crispycookies/watchPLB/eagle/BOMs/BOMs_WatchPLB.xlsx

Sheet: Mainboard
Qty | Value | Device | Package | Parts | Description | Vorhanden | Link
22 | PTR1B1,27 | PTR1B1,27 | B1,27 | 3V3, BAT_ADC, BAT_PACK_POS, BTN_1, BTN_2, BTN_3, BTN_4, BTN_NRST, BT_RX, BT_TX, NRST_MCU, RF_SYSCLK, SPI2_CLK, SPI2_IRQ, SPI2_MISO, SPI2_MOSI, SPI2_SEL_RFTX, SWD_RXD, SWD_TXD, USB_DN, USB_DP, USB_ID | TEST PIN |  | x
6 | BLM18KG601SN1D | B-EU_B0603 | L0603 | B1, B3, B4, B5, B6, B7 | EMI Filter | n | https://www.mouser.at/ProductDetail/Murata-Electronics/BLM18KG601SN1D
2 |  | PINHD-1X5 | 1X05 | BAT, CONFIG_INTERFACE_TEST_POINT | PIN HEADER |  | x
3 | 1uF | C-EUC0805 | C0805 | C10, C20, C27 | CAPACITOR, European symbol | n | https://www.mouser.at/ProductDetail/Yageo/CC0805KKX5R6BB105
2 | 27p | C-EUC0805 | C0805 | C14, C15 | CAPACITOR, European symbol | n | https://www.mouser.at/ProductDetail/KEMET/C0805C270J1GACTU?qs=sGAEpiMZZMs0AnBnWHyRQOf5HOpVaXbhYFtZQxfz6Es%3d
1 | CSTCE12M0G15L99-R0 | CSTCE8M00G52-R0 | CSTCE | C19 |  | y | https://www.mouser.at/ProductDetail/Murata-Electronics/CSTCE12M0G15L99-R0
2 | 27pF | C-EUC0805 | C0805 | C25, C26 | CAPACITOR, European symbol | y | https://www.mouser.at/ProductDetail/KEMET/C0805C270J1GACTU?qs=sGAEpiMZZMs0AnBnWHyRQOf5HOpVaXbhYFtZQxfz6Es%3d
2 | 7.5pF | C-EUC0805 | C0805 | C28, C31 | CAPACITOR, European symbol | y | https://www.mouser.at/ProductDetail/KEMET/C0805C759C5HACTU
2 | 2.7pF | C-EUC0805 | C0805 | C29, C30 | CAPACITOR, European symbol | n | https://www.mouser.at/ProductDetail/Vishay-Vitramon/VJ0805A2R7BXAPW1BC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
2 | 6pF | C-EUC0805 | C0805 | C32, C33 | CAPACITOR, European symbol | y | https://www.mouser.at/ProductDetail/AVX/08055A6R0CAT2A?qs=sGAEpiMZZMs0AnBnWHyRQEncggutzp42xImDo6lXcbY%3d
2 | 5.2pF | C-EUC0805 | C0805 | C34, C35 | CAPACITOR, European symbol | n | https://www.mouser.at/ProductDetail/KEMET/CBR08C529C5GAC
2 | NC | C-EUC0805 | C0805 | C36, C37 | CAPACITOR, European symbol |  | x
9 | 100nF | C-EUC0805K | C0805K | C38, C39, C40, C41, C44, C45, C46, C47, C49 | CAPACITOR, European symbol | n | https://www.mouser.at/ProductDetail/Wurth-Electronics/885012207098
15 | 100nF | C-EUC0805 | C0805 | C4, C5, C6, C7, C8, C11, C12, C13, C16, C17, C18, C21, C22, C23, C24 | CAPACITOR, European symbol | n | https://www.mouser.at/ProductDetail/Wurth-Electronics/885012207098
2 | 1uF | C-EUC0805K | C0805K | C42, C43 | CAPACITOR, European symbol | n | https://www.mouser.at/ProductDetail/Yageo/CC0805KKX5R6BB105
3 | 22uF | CPOL-EUE | PANASONIC_E | C48, C51, C52 | POLARIZED CAPACITOR, European symbol, 80-EDK226M050A9GAA | y | https://www.mouser.at/ProductDetail/KEMET/EDK226M050A9GAA
3 | 10uF | CPOL-EUE | PANASONIC_E | C53, C56, C59 | POLARIZED CAPACITOR, European symbol, 80-EDK106M025A9DAA | y | https://www.mouser.at/ProductDetail/KEMET/EDK106M025A9DAA
3 | 100uF | CPOL-EUE | PANASONIC_E | C54, C57, C60 | POLARIZED CAPACITOR, European symbol, 647-GYA1E101MCQ1GS | y | https://www.mouser.at/ProductDetail/Nichicon/GYA1E101MCQ1GS
3 | NP | CPOL-EUE | PANASONIC_E | C55, C58, C61 | POLARIZED CAPACITOR, European symbol |  | x
1 | 4.7uF | CPOL-EUB/3528-21R | B/3528-21R | C63 | POLARIZED CAPACITOR, European symbol, low esr 80-T521B475M35ATE150 | y | https://www.mouser.at/ProductDetail/KEMET/T521B475M035ATE150
1 | 10uF | C-EUC1206 | C1206 | C9 | CAPACITOR, European symbol | y | https://www.mouser.at/ProductDetail/Vishay-Vitramon/VJ1206G106KXYTW1BC
1 | S8NC-13 | DIODE-SMC | SMC | D1 | DIODE | y | https://www.mouser.at/ProductDetail/Diodes-Incorporated/S8NC-13
1 | MBRS330T3 | MBRS330T3 | SMC | D10 | SCHOTTKY BARRIER RECTIFIER 3.0 AMPERES 20, 30, 40 VOLT | y | https://www.mouser.at/ProductDetail/ON-Semiconductor/MBRS330T3G
6 | 1N4148 | DIODESOD-123 | SOD-123 | D2, D3, D4, D5, D8, D9 | Diode | y | https://www.mouser.at/ProductDetail/Diodes-Incorporated/1N4148W-7-F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
1 | Zener 16V | DIODE-SOD323-R | SOD323-R | D6 | DIODE, MMSZ5246BS-7-F | y | https://www.mouser.at/ProductDetail/Diodes-Incorporated/MMSZ5246BS-7-F
1 | 100V, BAS16J,135 | DIODE-SOD323-R | SOD323-R | D7 | DIODE | y | https://www.mouser.at/ProductDetail/Nexperia/BAS16J135?qs=sGAEpiMZZMtoHjESLttvkoI3HUJtjVU1BZwVLB9Jeuw%3d
3 | BLM18PG300SN1D | FERRITE_BEAD-0603 | 0603 | FB1, FB3, FB4 | Ferrite Bead (blocks, cores, rings, chokes, etc.) | y | https://www.mouser.at/ProductDetail/Murata-Electronics/BLM18PG300SN1D
1 |  | PINHD-1X8 | 1X08 | GPS> | PIN HEADER |  | x
1 | LT1513 | LT1513 | TO220-7 | IC1 | Battery Charger Buck/Boost | y | https://www.mouser.at/ProductDetail/Analog-Devices-Linear-Technology/LT1513-2CRPBF
1 | BM70BLES1FC2-0B03AA | BM70BLES1FC2-0B03AA | BM78SPPS5NC2_1 | IC2 | Bluetooth / 802.15.1 Modules | y | https://www.mouser.at/ProductDetail/Microchip-Technology/BM70BLES1FC2-0B03AA
1 | LM1117DTX-ADJ-12V | LM1117DTX-ADJ | TO252 | IC3 |  | n | https://www.mouser.at/ProductDetail/Texas-Instruments/LM1117DTX-ADJ-NOPB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
1 | AX5031 | AX5031 | QFN20 | IC4 | AX5031 RF Transmitter 400-470MHz 800-940MHz | y | https://www.mouser.at/ProductDetail/ON-Semiconductor/AX5031-1-TW30
1 | LM1117DTX-ADJ-10V | LM1117DTX-ADJ | TO252 | IC5 |  | y | https://www.mouser.at/ProductDetail/Texas-Instruments/LM1117DTX-ADJ-NOPB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
1 | LM1117DTX-ADJ-3V3 | LM1117DTX-ADJ | TO252 | IC6 |  | y | https://www.mouser.at/ProductDetail/Texas-Instruments/LM1117DTX-ADJ-NOPB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
3 |  | USB_MICRO-B_FEMALE-SMT | USB-B-MICRO-SMD | J1, J2, J4 | USB Type Micro-B Connector | y | https://www.mouser.at/ProductDetail/Amphenol-FCI/10118192-0001LF
1 | BNCPTH | BNCPTH | BNC | J3 | BNC Right Angle Connector | y | https://www.sparkfun.com/products/10550
1 | VIB_MOTOR | PINHD-1X2 | 1X02 | JP2 | PIN HEADER, 619-28821 | n | https://www.mouser.at/ProductDetail/Parallax/28821
1 | Power Disconnect | PINHD-1X2 | 1X02 | JP3 | PIN HEADER |  | x
2 | 39nH | INDUCTOR-0805-3.3UH | 0805 | L1, L4 | Inductors | y | https://www.mouser.at/ProductDetail/Bourns/CE201210-39NJ
2 | 120nH | INDUCTOR-0805-3.3UH | 0805 | L2, L3 | Inductors | y | https://www.mouser.at/ProductDetail/Bourns/CV201210-R12K
2 | 27nH | INDUCTOR-0805-3.3UH | 0805 | L5, L6 | Inductors | y | https://www.mouser.at/ProductDetail/Bourns/CE201210-27NJ
1 | 0R | INDUCTOR-0805-3.3UH | 0805 | L7 | Inductors | y | https://www.mouser.at/ProductDetail/Vishay-Draloric/RCG08050000Z0EA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
1 | CTX10-4A-R | CTX10-4A-R | INDM115115X635N | L8 | POWER INDUCTOR | y | https://www.mouser.at/ProductDetail/Coiltronics-Eaton/CTX10-4A-R
2 | BLUE | LEDCHIP-LED0805 | CHIP-LED0805 | LED1, LED3 | LED | n | https://www.mouser.at/ProductDetail/Wurth-Electronics/150080BS75000
1 | YELLOW | LEDCHIP-LED0805 | CHIP-LED0805 | LED10 | LED | n | https://www.mouser.at/ProductDetail/Wurth-Electronics/150080YS75000
5 | GREEN | LEDCHIP-LED0805 | CHIP-LED0805 | LED2, LED6, LED7, LED8, LED11 | LED | n | https://www.mouser.at/ProductDetail/Wurth-Electronics/150080GS75000
1 | WHITE | LEDCHIP-LED0805 | CHIP-LED0805 | LED4 | LED | y | https://www.mouser.at/ProductDetail/Lite-On/LTW-170TK
3 | RED | LEDCHIP-LED0805 | CHIP-LED0805 | LED5, LED9, LED12 | LED | n | https://www.mouser.at/ProductDetail/Wurth-Electronics/150080RS75000
1 | SWD | PINHD-1X5 | 1X05 | PR0> | PIN HEADER |  | x
1 | 8MHz-Crystal | CRYSTALHC49UP | HC49UP | Q1 | CRYSTAL, 8MHz / LFXTAL020423Reel | y | https://www.mouser.at/ProductDetail/IQD/LFXTAL020423Bulk
1 | BC817-25SMD | BC817-25SMD | SOT23-BEC | Q2 | NPN Transistor | y | https://www.mouser.at/ProductDetail/ON-Semiconductor/BC817-16LT3G
2 | DMN3023L-7 | BSS123 | SOT23 | Q3, Q7 | N-CHANNEL MOS FET | y | https://www.mouser.at/ProductDetail/Diodes-Incorporated/DMN3023L-7
1 | 16MHz_Crystal | CRYSTALHC49UP | HC49UP | Q4 | CRYSTAL, 16MHz_LFXTAL051370Reel | y | https://www.mouser.at/ProductDetail/IQD/LFXTAL051370Reel
2 | CSD18534Q5A | CSD18534Q5A | TRANS_CSD18534Q5A | Q5, Q6 | 60V N-Channel NexFET Power? MOSFET 8-VSON-FET -55 to 150 | y | https://www.mouser.at/ProductDetail/Texas-Instruments/CSD18534Q5AT
9 | 470R | R-EU_M0805 | M0805 | R10, R11, R14, R15, R18, R19, R20, R21, R22 | RESISTOR, European symbol | n | https://www.mouser.at/ProductDetail/Bourns/CR0805-FX-4700ELF?qs=sGAEpiMZZMtlubZbdhIBIDEmHCAUH0R0Vf1IHPeLRm0%3d
2 | 100k | R-EU_M0805 | M0805 | R25, R26 | RESISTOR, European symbol | n | https://www.mouser.at/ProductDetail/Susumu/RR1220P-104-D?qs=sGAEpiMZZMtlubZbdhIBIHPiT0YkkodQxrHTIurjrno%3d
1 | 1k5 | R-EU_M0805 | M0805 | R27 | RESISTOR, European symbol | n | https://www.mouser.at/ProductDetail/Susumu/RR1220P-152-D?qs=sGAEpiMZZMtlubZbdhIBIHPiT0YkkodQ7VAZokmK9Jk%3d
1 | 36k | R-EU_M0805 | M0805 | R28 | RESISTOR, European symbol | y | https://www.mouser.at/ProductDetail/Vishay/CRCW080536K0FKEA
1 | 4k7 | R-EU_M0805 | M0805 | R3 | RESISTOR, European symbol | n | https://www.mouser.at/ProductDetail/Susumu/RR1220P-472-D
5 | 1k | R-EU_M0805 | M0805 | R30, R31, R32, R33, R34 | RESISTOR, European symbol | n | https://www.mouser.at/ProductDetail/Susumu/RR1220P-102-D
1 | 20mR | R-EU_R2512 | R2512 | R36 | RESISTOR, European symbol | y | https://www.mouser.at/ProductDetail/Vishay-Dale/RCWE251220L0FMEA
2 | 100R | R-EU_M0805 | M0805 | R37, R38 | RESISTOR, European symbol | n | https://www.mouser.at/ProductDetail/Susumu/RR1220P-101-D?qs=sGAEpiMZZMtlubZbdhIBIHPiT0YkkodQf9vl5gvjsrU%3d
1 | 10M | R-EU_M0805 | M0805 | R39 | RESISTOR, European symbol | n | https://www.mouser.at/ProductDetail/Vishay/CRCW080510M0FKEB?qs=sGAEpiMZZMtlubZbdhIBIKpw3Cj3Rl3MNI5nZ86TRkY%3d
5 | 47k | R-EU_M0805 | M0805 | R4, R54, R56, R58, R60 | RESISTOR, European symbol | n | https://www.mouser.at/ProductDetail/Bourns/CR0805-FX-4702ELF?qs=sGAEpiMZZMtlubZbdhIBIDEmHCAUH0R0BYFVnl4ZjVo%3d
5 | 5k1 | R-EU_M0805 | M0805 | R40, R43, R53, R55, R57 | RESISTOR, European symbol | y | https://www.mouser.at/ProductDetail/Bourns/CR0805-FX-5101ELF
1 | 3M3 | R-EU_M0805 | M0805 | R41 | RESISTOR, European symbol | y | https://www.mouser.at/ProductDetail/Vishay/CRCW08053M30FKEA
1 | 1M | R-EU_M0805 | M0805 | R42 | RESISTOR, European symbol | n | https://www.mouser.at/ProductDetail/Vishay-Draloric/RCG08051M00FKEA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
1 | 470k | R-EU_M0805 | M0805 | R44 | RESISTOR, European symbol | n | https://www.mouser.at/ProductDetail/Susumu/RR1220P-474-D
1 | 330 | R-EU_M0805 | M0805 | R45 | RESISTOR, European symbol | n | https://www.mouser.at/ProductDetail/Susumu/RR1220P-331-D
1 | 910R | R-EU_M0805 | M0805 | R46 | RESISTOR, European symbol | y | https://www.mouser.at/ProductDetail/Susumu/RR1220P-911-D
1 | 330k | R-EU_M0805 | M0805 | R48 | RESISTOR, European symbol | n | https://www.mouser.at/ProductDetail/Susumu/RR1220P-334-D
14 | 10k | R-EU_M0805 | M0805 | R5, R6, R7, R8, R12, R13, R16, R17, R35, R47, R49, R59, R61, R29 | RESISTOR, European symbol | y | https://www.mouser.at/ProductDetail/Susumu/RR1220P-103-D?qs=sGAEpiMZZMtlubZbdhIBIHPiT0YkkodQv1fGEJmXcHQ%3d
1 | 0.25R | R-EU_R2512 | R2512 | R50 | RESISTOR, European symbol | y | https://www.mouser.at/ProductDetail/Yageo/RL2512FK-070R25L
1 | 120k | R-EU_M0805 | M0805 | R51 | RESISTOR, European symbol | n | https://www.mouser.at/ProductDetail/Vishay/CRCW0805120KFKEB?qs=sGAEpiMZZMtlubZbdhIBIMnmA7lvh4oLM85S5wRYrbI%3d
1 | 12k4 | R-EU_M0805 | M0805 | R52 | RESISTOR, European symbol | y | https://www.mouser.at/ProductDetail/Susumu/RR1220P-1242-D-M?qs=sGAEpiMZZMtlubZbdhIBIHPiT0YkkodQJw4mRx63pQY%3d
1 | NTC 103AT | R-EU_M0805 | M0805 | R62 | RESISTOR, European symbol | y | https://www.mouser.at/ProductDetail/Semitec/103AT-4-70374
3 | 220R | R-EU_M0805 | M0805 | R9, R23, R24 | RESISTOR, European symbol | n | https://www.mouser.at/ProductDetail/Susumu/RR1220P-221-D
1 | PTR1B2,54 | PTR1B2,54 | B2,54 | RF_SIGNAL | TEST PIN |  | x
5 |  | TL3305 | SMD_SWITCH | S1, S2, S3, S4, S5 | OMRON SWITCH | y | https://www.mouser.at/ProductDetail/E-Switch/TL3305AF260QG
1 | RA07H4047M | RA07H4047M | RA07H4047M | U$2 |  | y | https://www.rfparts.com/module/rfpower-mosfet/mosfetpowermod-uhflp/ra07h4047m.html
1 | MCP111-XXXXX/TO | MCP111-XXXXX/TO | TO-92_MC | U1 |  | y | https://www.mouser.at/ProductDetail/Microchip-Technology/MCP111T-195I-LB?qs=sGAEpiMZZMsUzhEcHltCuaykJbWoyfaD
1 | STM32L073RZ | STM32L0X3RL | LQFP64-10X10MM | U2 |  | y | https://www.mouser.at/ProductDetail/STMicroelectronics/STM32L073RZT6
1 | MCP2200-I/SS | MCP2200-I/SS | SSOP20_MC | U3 |  | y | https://www.mouser.at/ProductDetail/Microchip-Technology/MCP2200-I-SS
1 | TPD3E001DRLR | TPD3E001DRLR | SOT50P160X60-5N | U4 | LOW-CAPACITANCE 3-CHANNEL ±15-kV ESD-PROTECTION ARRAY FOR HIGH-SPEED DATA INTERFACES | y | https://www.mouser.at/ProductDetail/Texas-Instruments/TPD3E001DRLR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
1 | BQ7790504 | BQ77904 | TSSOP-20/6MM | U5 | A battery protection chip with OV/UV/OT/UT | y | https://www.digikey.at/products/de?keywords=296-44599-5-ND
1 | BNC Kabel |  |  |  |  | n | https://www.mouser.at/ProductDetail/AIM-Cambridge-Cinch-Connectivity-Solutions/606BBP
4 | Akku 18650 |  |  |  |  | n | https://eu.nkon.nl/rechargeable/18650-size/lg-inr18650-f1l-3350mah-4-8a.html
1 | Akkuhalter |  |  |  |  | y | https://www.digikey.at/products/de/battery-products/battery-holders-clips-contacts/86?k=18650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
1 | Antenne | av200 |  |  |  | y | http://www.air-store.eu/epages/AIRStore-LuftfahrtbedarfundAvionik.sf/en_GB/
3 | USB Kabel micro |  |  |  |  | 3 von 9 | https://www.mouser.at/ProductDetail/Bridgetek/VA-FC-1M-BKW
1 | Pinheader Male 2.54mm |  |  |  |  | n | https://www.aliexpress.com/item/10Pcs-Lot-40-Pin-2-54mm-1x40-pin-Heigth-11-34MM-Single-Row-Male-straight-male/32873942371.html
1 | Pinheader Female 2.54mm |  |  |  |  | n | https://www.aliexpress.com/item/10Pcs-Lot-40Pin-2-54mm-1x40-pin-socket-Single-Row-Female-straight-female-Pin-Header-Connector/32892752726.html

Sheet: GPS_Board
Qty | Value | Device | Package | Parts | Description | Bezugsquelle
1 |  | PINHD-1X8 | 1X08 | <GPS | PIN HEADER
3 | 1uF | C-EUC0805 | C0805 | C1, C2, C3 | CAPACITOR, European symbol | https://www.mouser.at/ProductDetail/77-VJ0805V105ZXJCBC
1 | 4.7uF | C-EUC0805 | C0805 | C4 | CAPACITOR, European symbol | https://www.mouser.at/ProductDetail/710-885012107013
2 | 47k | R-EU_M0805 | M0805 | R1, R2 | RESISTOR, European symbol | https://www.mouser.at/ProductDetail/667-ERJ-2GEJ473X
1 | BLM18KG601SN1D | B-EU_B0603 | L0603 | B2 | EMI Filter | https://www.mouser.at/ProductDetail/81-BLM18KG601SN1D
1 | SAM-M8Q | SAM-M8Q | SAM-M8Q | IC1 | u-blox SAM GNSS antenna module | https://www.u-blox.com/de/product/sam-m8q-module
