crispycookies/watchPLB/Berechnungen.xlsx

Sheet: BatteryCharger
vBat | 16.8 | V | Vbat error | 0.001379903852
R2 | 12400 | Ohm | R52
R1 | 154463.7709 | Ohm | R51 | 150000
R3 | 0.25 | Ohm | R50
R4 | 3900 | Ohm | R49
viset_precharge | 0.3 | V
viset_charge | 3.3 | V
icharge | 0.156 | A | calculated | 0.15576
R5 | 330000 | Ohm | R48
R5 gewählt | 330000
iprecharge | 0.01418181818 | A

Sheet: Stromverbrauch
Maximaler Dauerhafter Stromverbrauch
STM | 7.4 | mA
LEDS | 2.7 | mA | 0.3*9
USB to UART | 12 | mA
GPS | 25 | mA
BLE | 13 | mA
Gesamt ma | 60.1
Gesamt a | 0.0601
BatterieSpannung | 16.8 | V
Versorgungsspannung | 3.3 | V
Verlustleistung | 0.81135

Sheet: Spannungsregler
 | 4s zu 12.5V | 4s zu 10V | 10V zu 3V3
Int.referenz | 1.25 | 1.25 | 1.25 | V
Ausgangsspannung Ziel | 12.5 | 10 | 3.3 | V
R1 (ausgewählt) | 5100 | 5100 | 5100 | Ohm
R2 (Berechnet) | 45900 | 35700 | 8364 | Ohm
R2 (ausgewählt | 47000 | 33000 | 8200 | Ohm
Ausgangsspannung | 12.77 | 9.34 | 3.26 | V

Sheet: Batteriespannungsmessung
Spannungsteiler
Eingang | 16.8 | V
oberer R | 47000 | Ohm
unterer R | 10000 | Ohm
gewünschte max.Ausgang | 3 | V
berechneter max ausgang | 2.947368421 | V
