crispycookies/watchPLB/eagle/Doku/WatchPLB_Hardware.pdf

## Abbildungsverzeichnis

1 | Mikrocontroller STM32F0 | | 2
2 | USB-To-UART und USB des STM | | 3
3 | Bluetooth-Modul | | 4
4 | Lithium-Ionen-Akku Schutzschaltung | | 5
5 | Akkuladeschaltung und Spannungsregler | | 6
6 | Taster, WakeUp, Vibrationsmotor | | 7
7 | Funk | | 8
8 | GPS-Modul | | 9

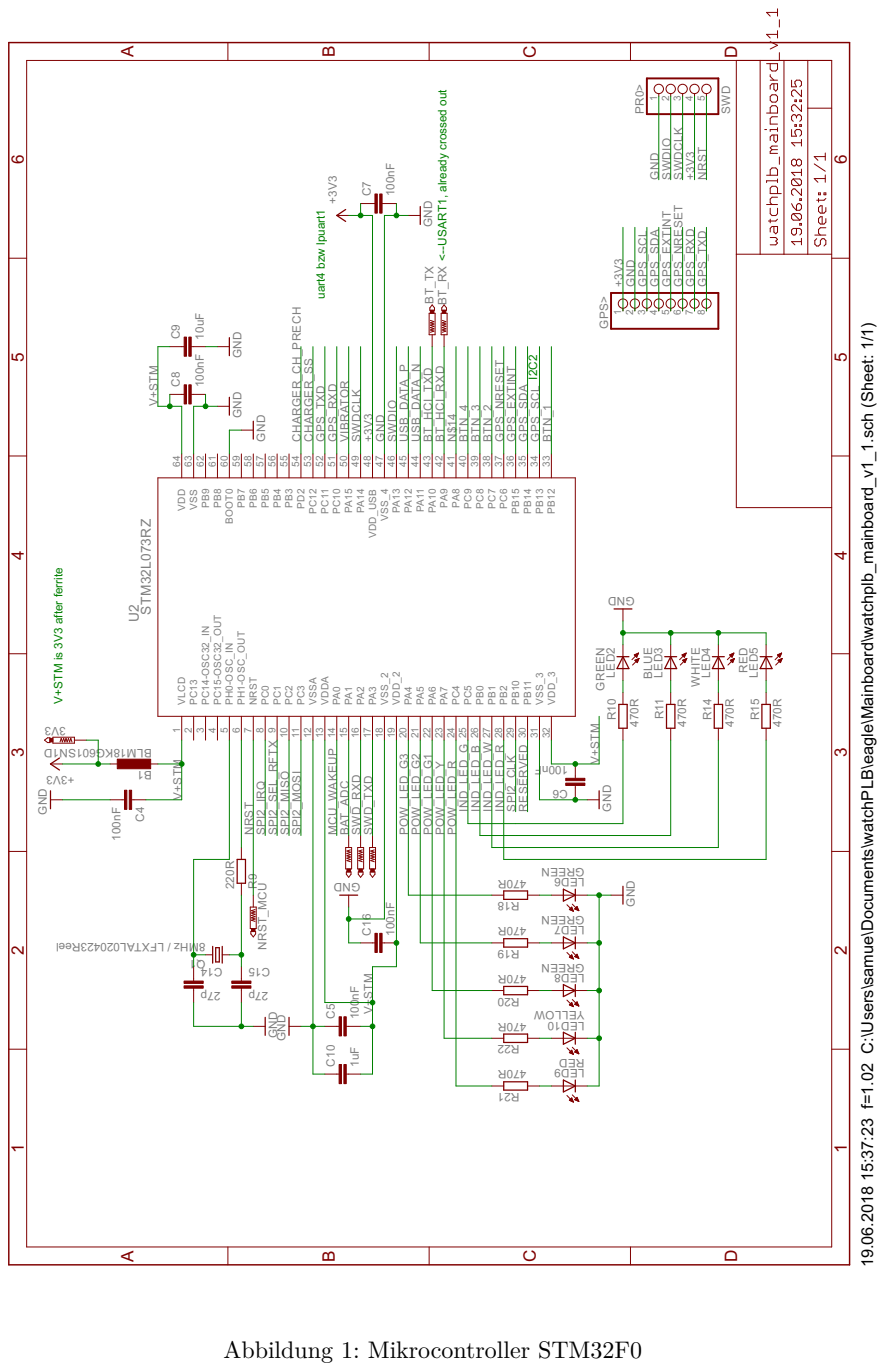
[picture p10: page 2]

19.06.2018 15:37:23 f=1.02 C:\Users\samue\Documents\watchPLB\eagle\Mainboard\watchplb_mainboard_v1_1.sch (Sheet: 1/1)

V+STM is 3V3 after ferrite

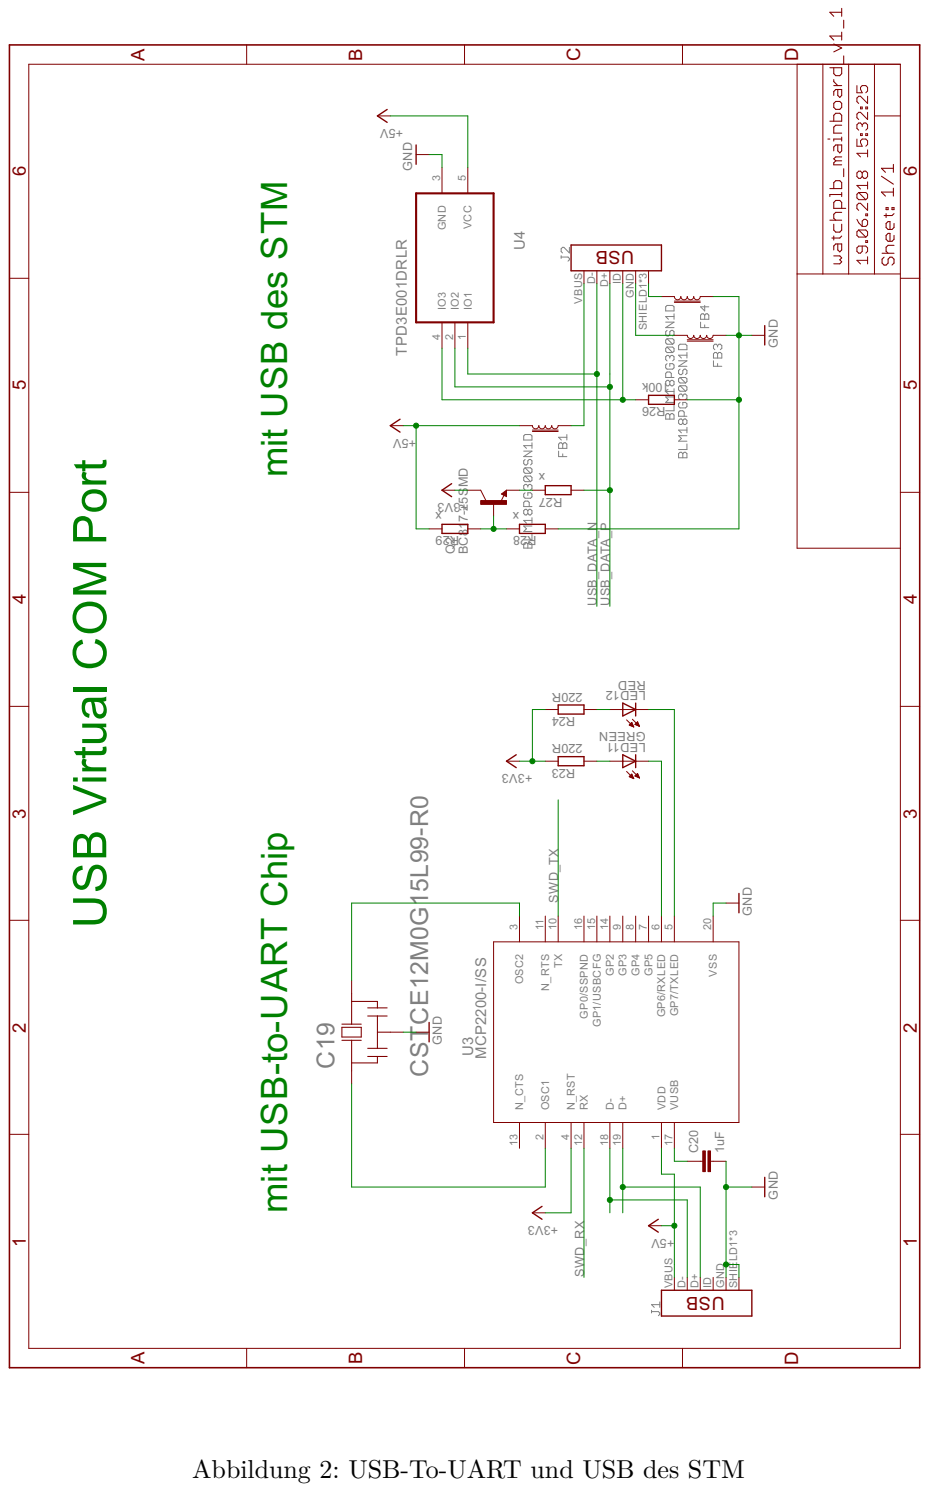
[picture p11: page 3]
MCP2200-I/SS; CSTCE12M0G15L99-R0; GND; TPD3E001DRLR; BC817-25SMD; DMN3023L-7; N_CTS; OSC1; 2 N_RST; 19 VDD; 1 VUSB; OSC2; 3 N_RTS; GP0/SSPND; GP1/USBCFG; 7 GP6/RXLED; GP7/TXLED; 5 VSS; D+D- VBUS; SHIELD1*3; VCC; 5 GND; SWD_RX; SWD_TX; USB_DATA_P; USB_DATA_N; CHARGER_CH_PRECH

mit USB des STM mit USB-to-UART Chip

USB Virtual COM Port

Abbildung 2: USB-To-UART und USB des STM

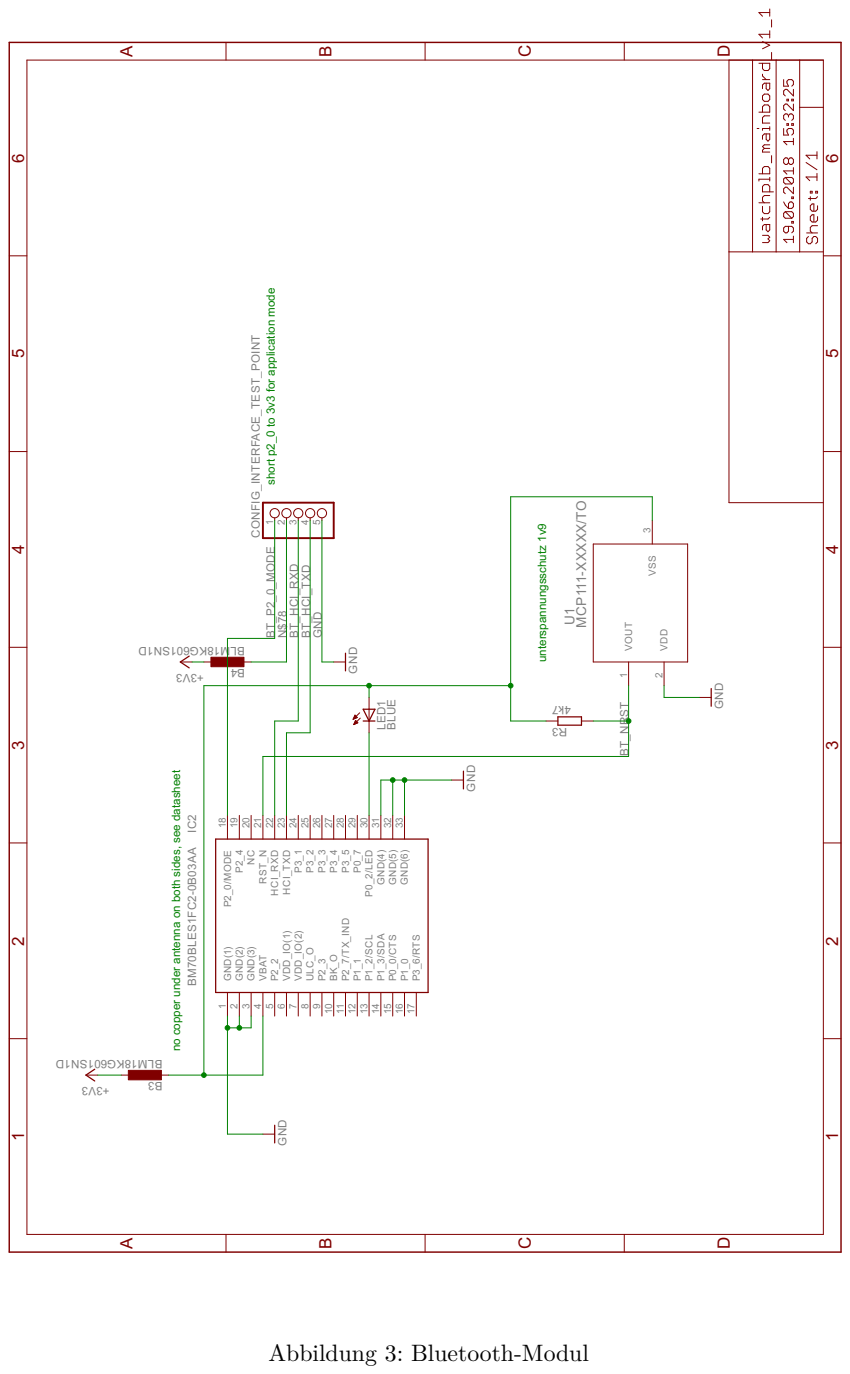
[picture p12: page 4]
BM70BLES1FC2-0B03AA; GND; MCP111-XXXXX/TO; BLUE; GND(1) 1; GND(2) 2; GND(3) 3 VBAT; 5 VDD_IO(1) 6 VDD_IO(2) 7 ULC_O; 10 P2_7/TX_IND; 12 P1_2/SCL; 13 P1_3/SDA 14 P0_0/CTS 15 P1_0; 16 P3_6/RTS; P2_0/MODE; 20 RST_N; 21 HCI_RXD; 22 HCI_TXD; 29 P0_2/LED; GND(4) 31; GND(5) 32; GND(6) 33; VOUT 1 VDD; 2 VSS; CONFIG_INTERFACE_TEST_POINT; BT_NRST; BT_P2_0_MODE; BT_HCI_RXD; BT_HCI_TXD; unterspannungsschutz 1v9

no copper under antenna on both sides, see datasheet short p2_0 to 3v3 for application mode

Abbildung 3: Bluetooth-Modul

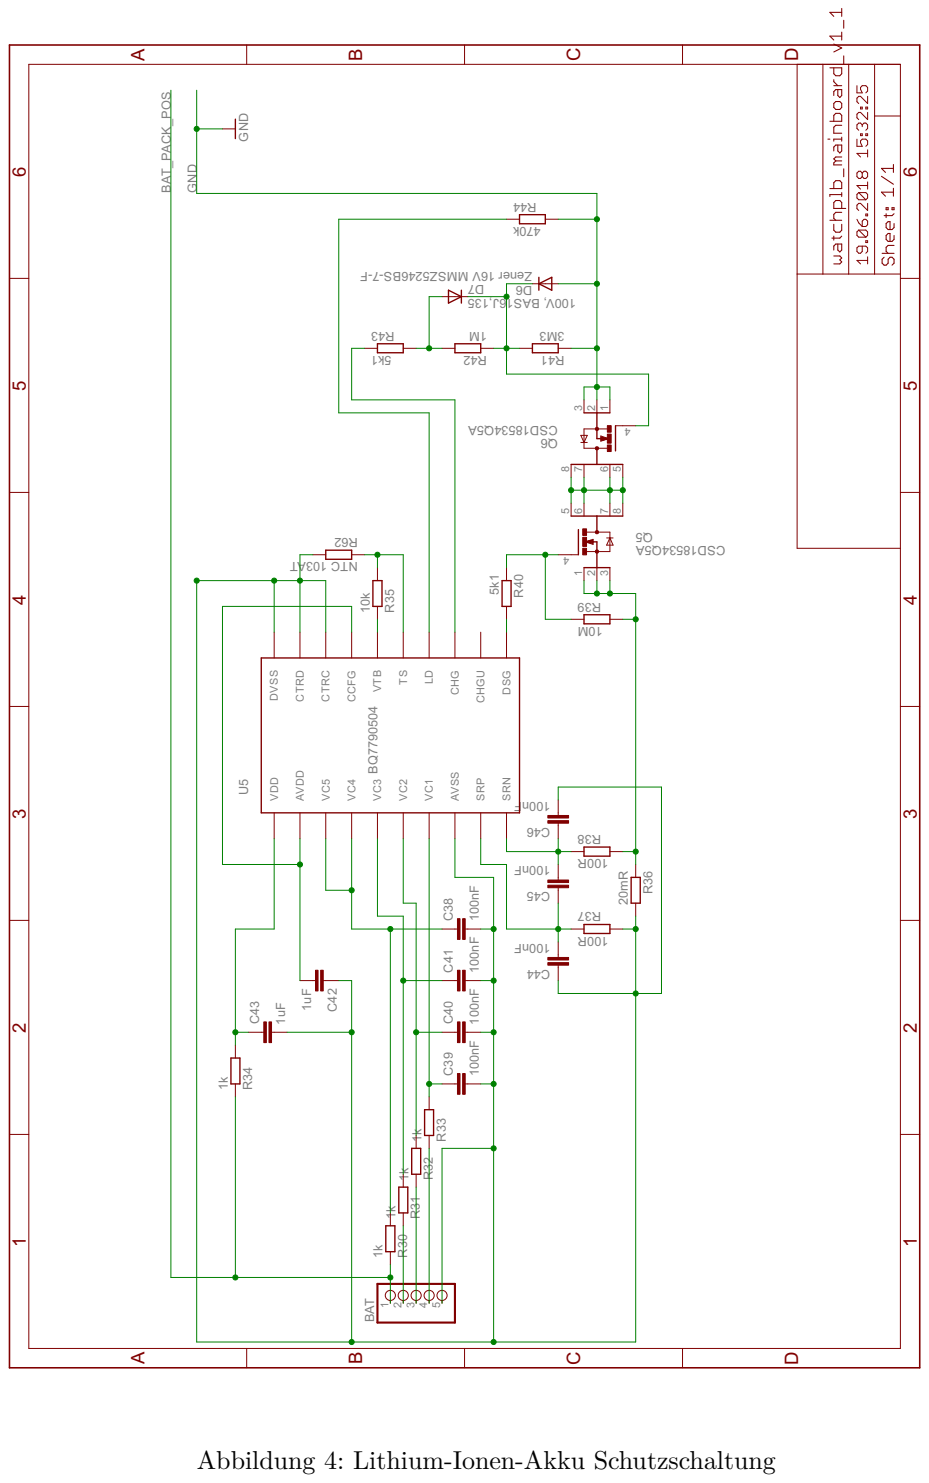
[picture p13: page 5]

Abbildung 4: Lithium-Ionen-Akku Schutzschaltung

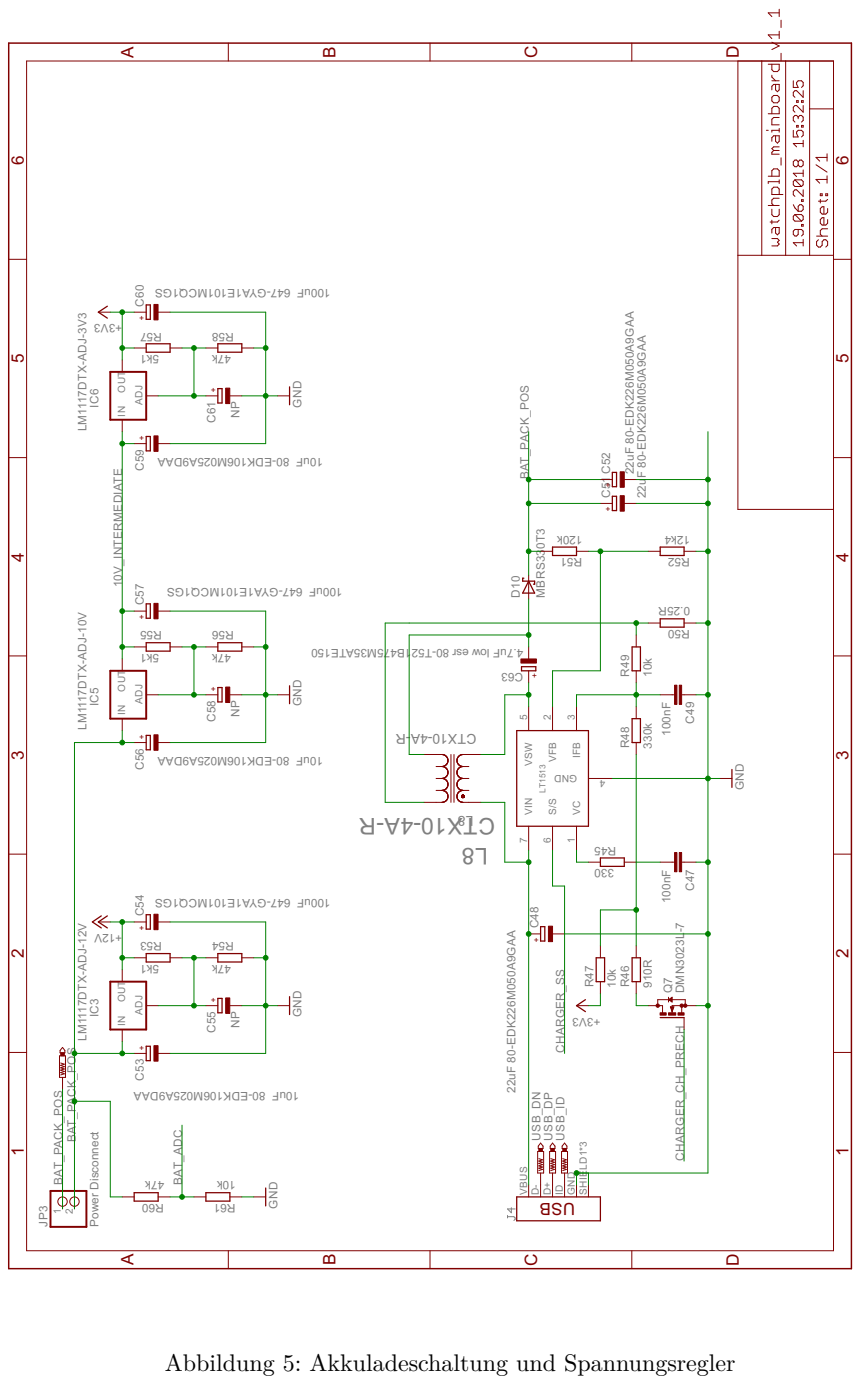
[picture p14: page 6]

Abbildung 5: Akkuladeschaltung und Spannungsregler

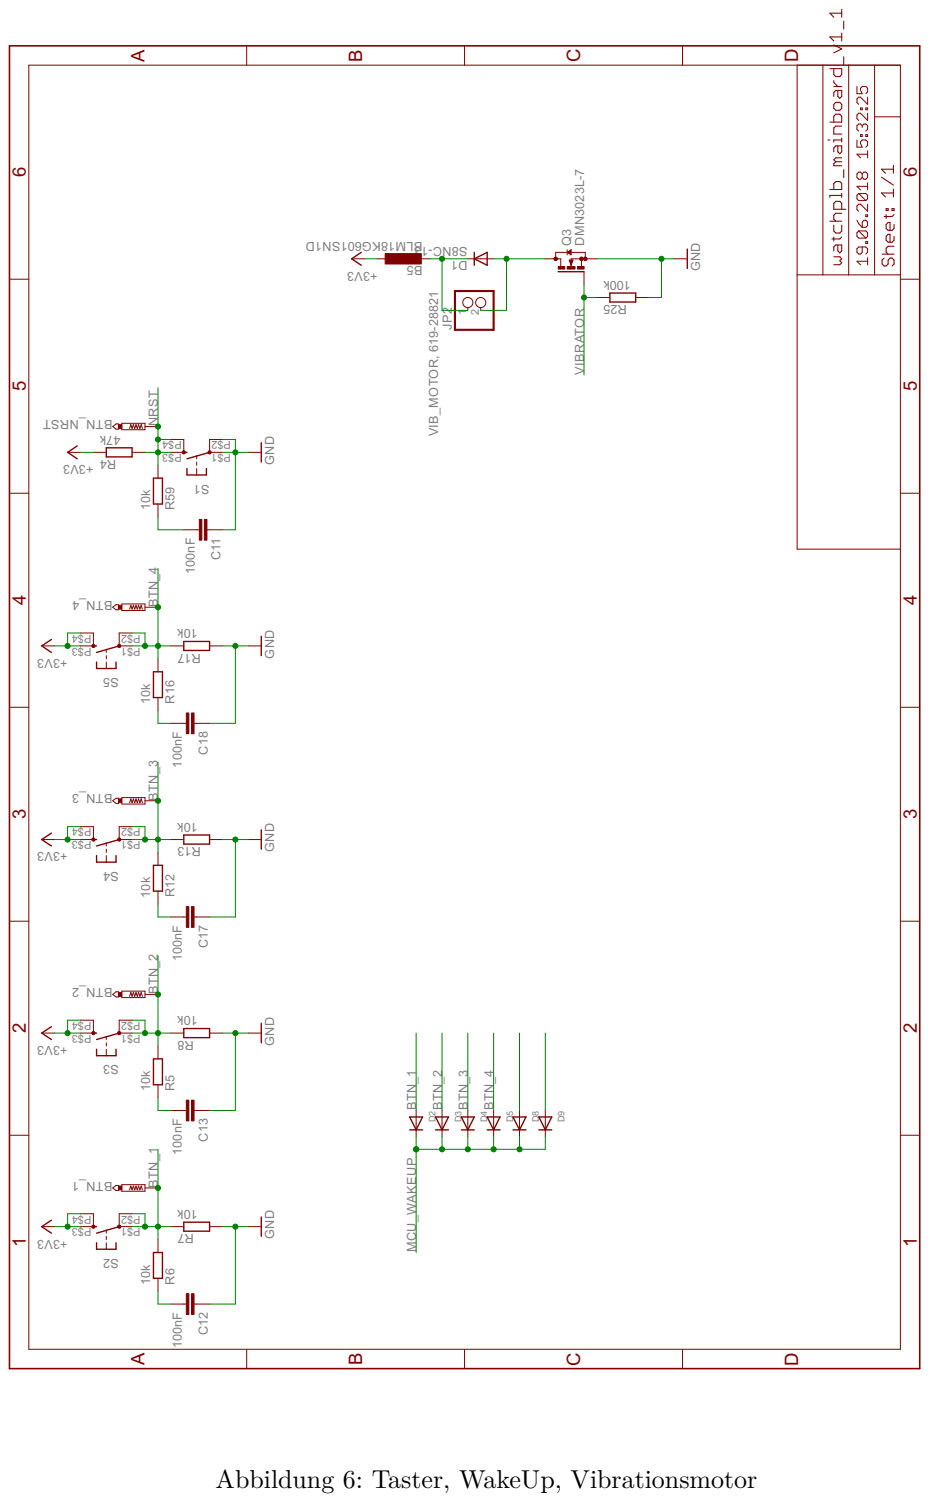
[picture p15: page 7]

Abbildung 6: Taster, WakeUp, Vibrationsmotor

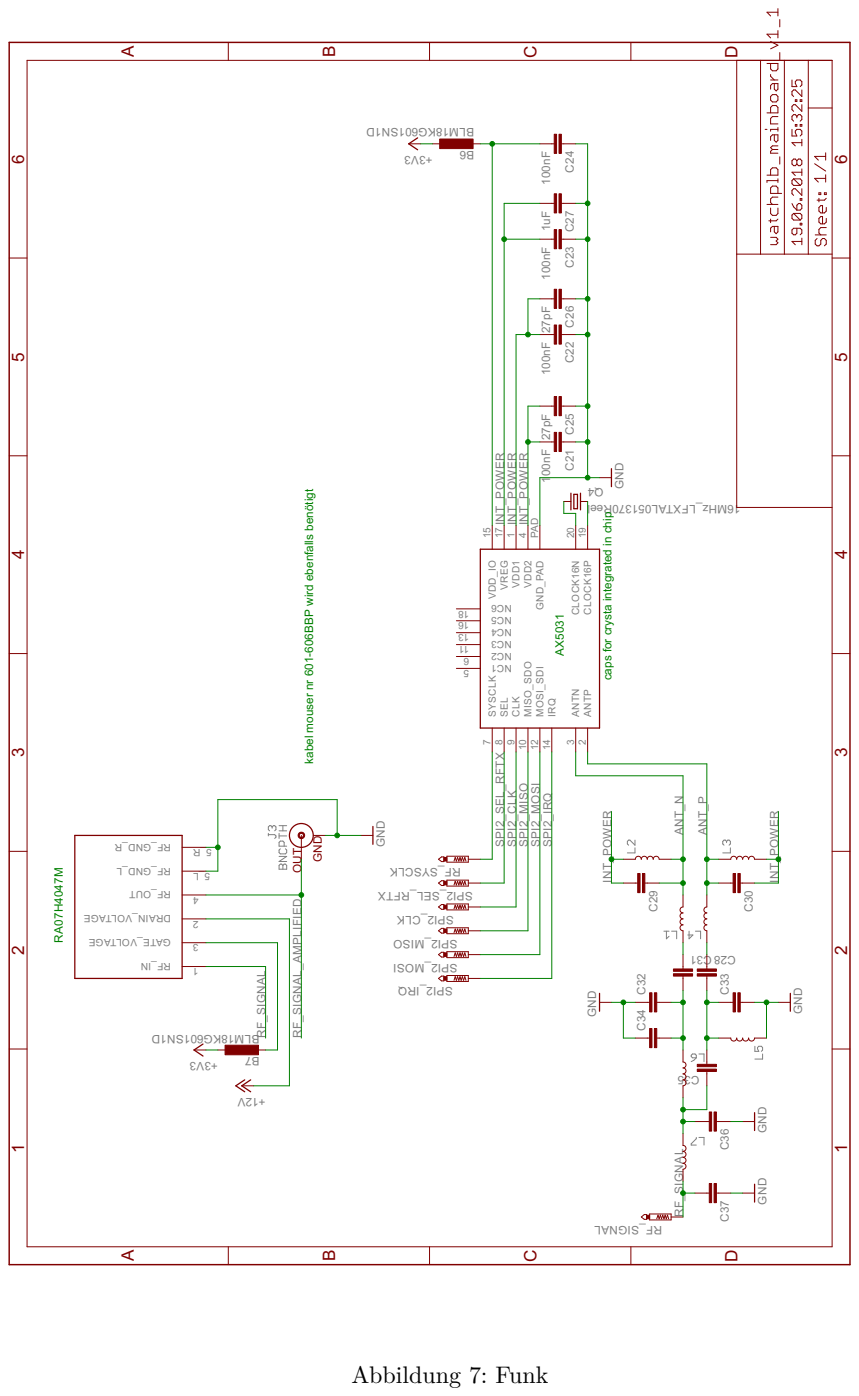
[picture p16: page 8]
GND; GND GND; VDD_IO; IRQ; 14 SYSCLK; 7 SEL; CLK; 9 MISO_SDO; 10 MOSI_SDI 12 VREG; 17 VDD1 1 VDD2; 4 ANTN; 3 ANTP; 2 CLOCK16N; CLOCK16P; GND_PAD; PAD; INT_POWER; SPI2_CLK; SPI2_MISO; SPI2_MOSI; SPI2_SEL_RFTX; SPI2_IRQ; ANT_N; ANT_P; RF_SIGNAL; RF_SIGNAL_AMPLIFIED; OUT; Abbildung 7: Funk

kabel mouser nr 601-606BBP wird ebenfalls benötigt

caps for crysta integrated in chip

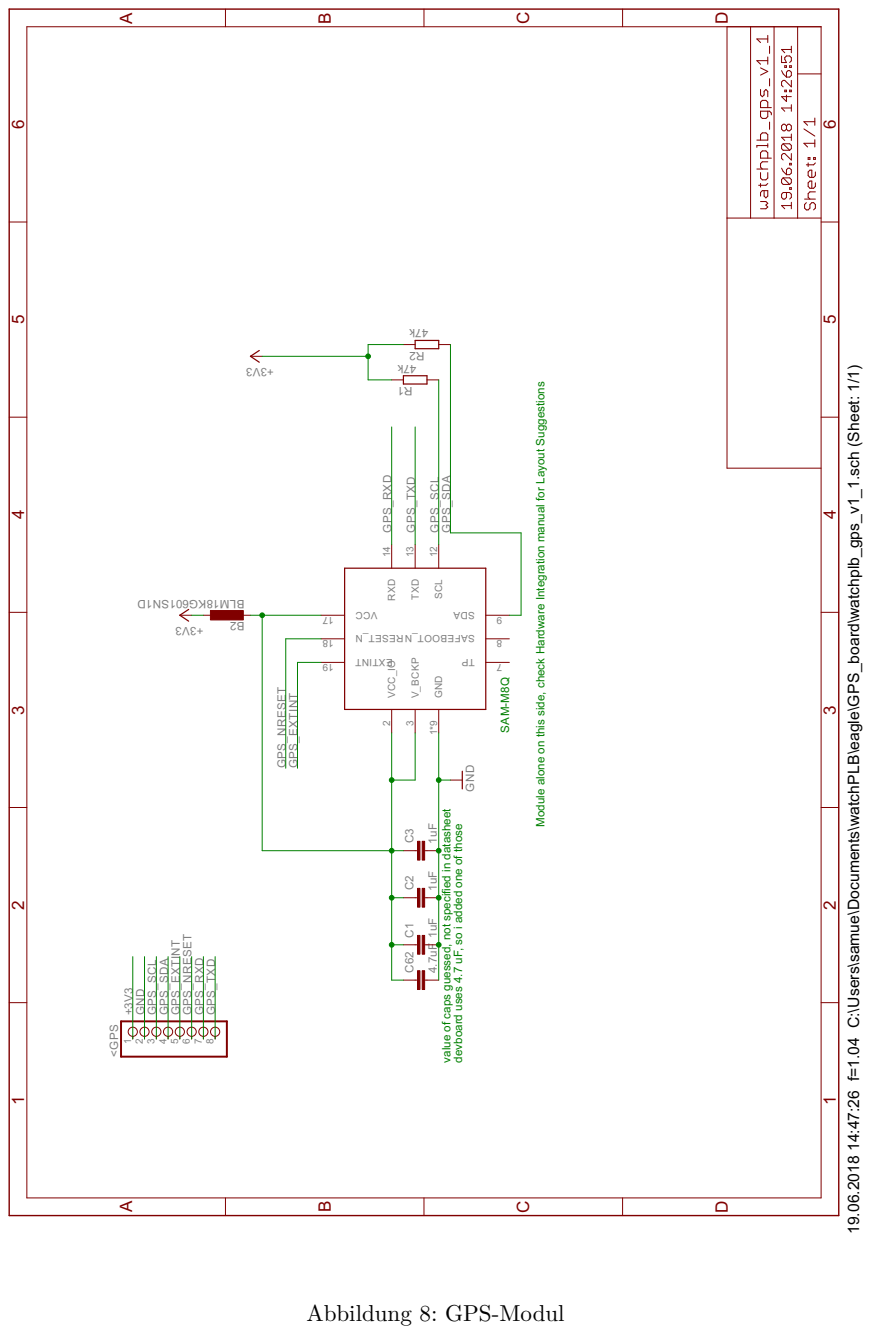
[picture p17: page 9]
GND; VCC_IO; V_BCKP; TXD; RXD; 14 CCV; <GPS; GPS_RXD; GPS_TXD; GPS_SCL; GPS_SDA; GPS_EXTINT; GPS_NRESET

19.06.2018 14:47:26 f=1.04 C:\Users\samue\Documents\watchPLB\eagle\GPS_board\watchplb_gps_v1_1.sch (Sheet: 1/1)

Module alone on this side, check Hardware Integration manual for Layout Suggestions

devboard uses 4.7 uF, so i added one of those SAM-M8Q

value of caps guessed, not specified in datasheet

Abbildung 8: GPS-Modul
