crispycookies/watchPLB/eagle/Mainboard/watchplb_mainboard_v1_0.pdf

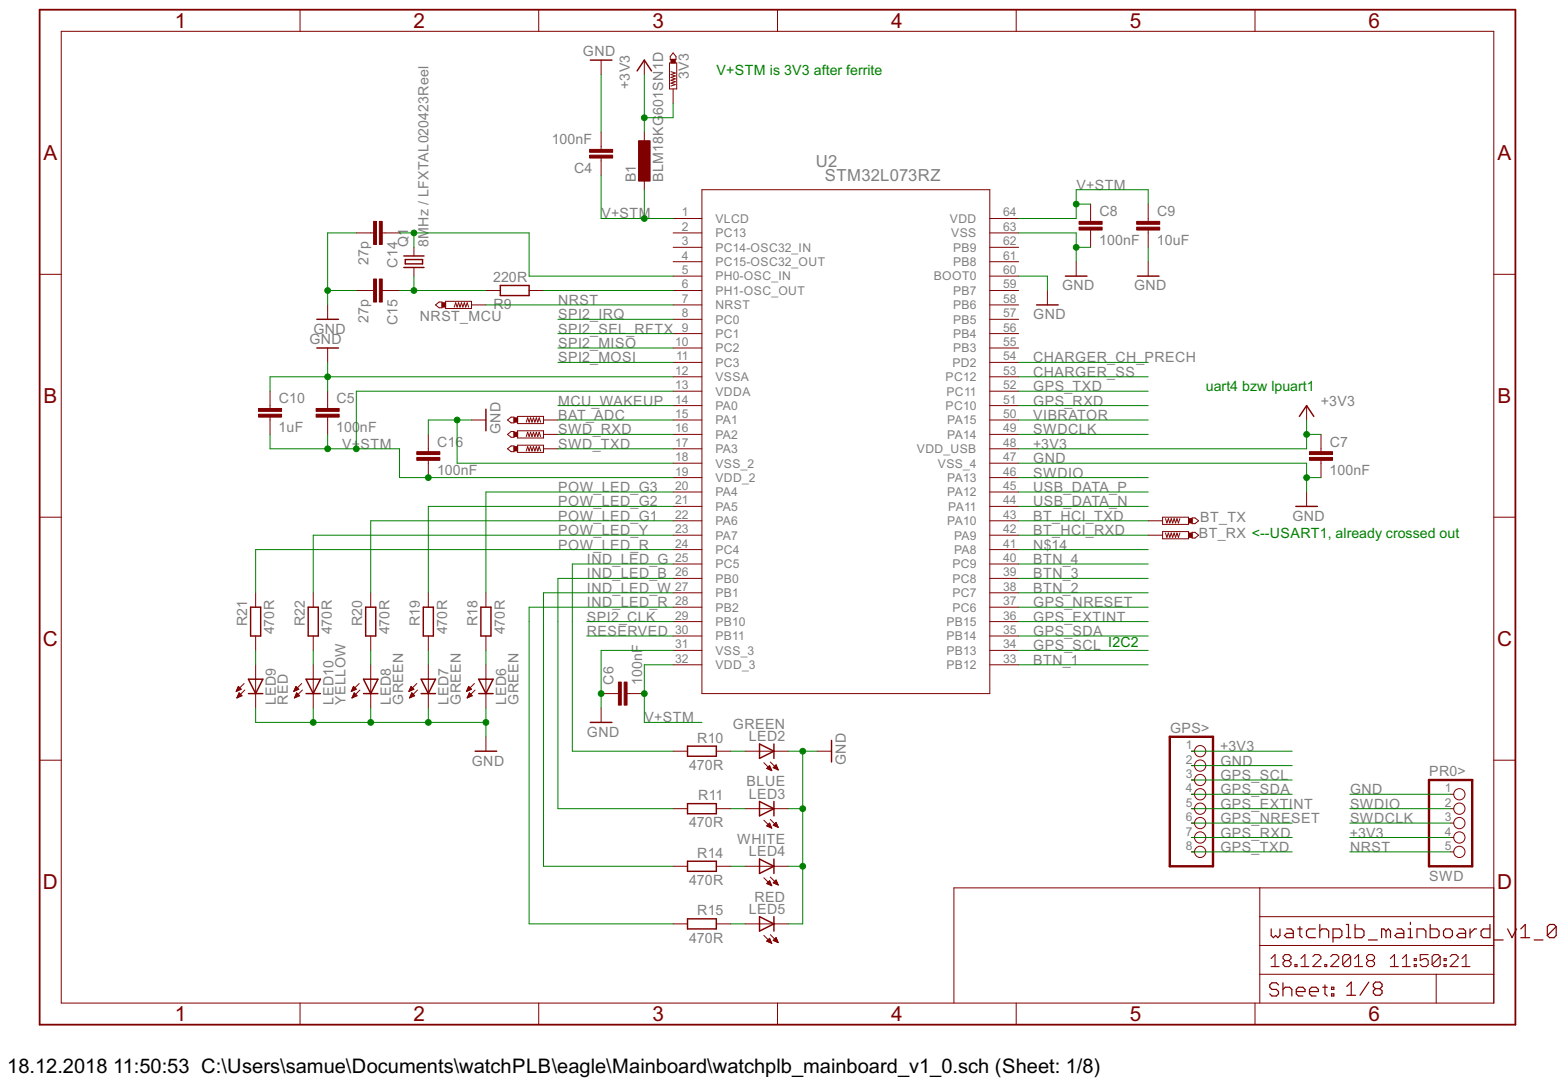
[picture p18: page 1]

GND

V+STM is 3V3 after ferrite

POW_LED_G2 | | 44 PA12 USB_DATA_N
POW_LED_G1 | | 43 PA11 BT_HCI_TXD 42 PA10 BT_HCI_RXD 41 PA9 N$14

POW_LED_R
IND_LED_G | | 40 PA8 BTN_4
IND_LED_B | | 39 PC9 BTN_3
IND_LED_W | | 38 PC8 BTN_2
IND_LED_R | | 37 PC7 GPS_NRESET
SPI2_CLK RESERVED | | 36 PC6 GPS_EXTINT

18.12.2018 11:50:53 C:\Users\samue\Documents\watchPLB\eagle\Mainboard\watchplb_mainboard_v1_0.sch (Sheet: 1/8)

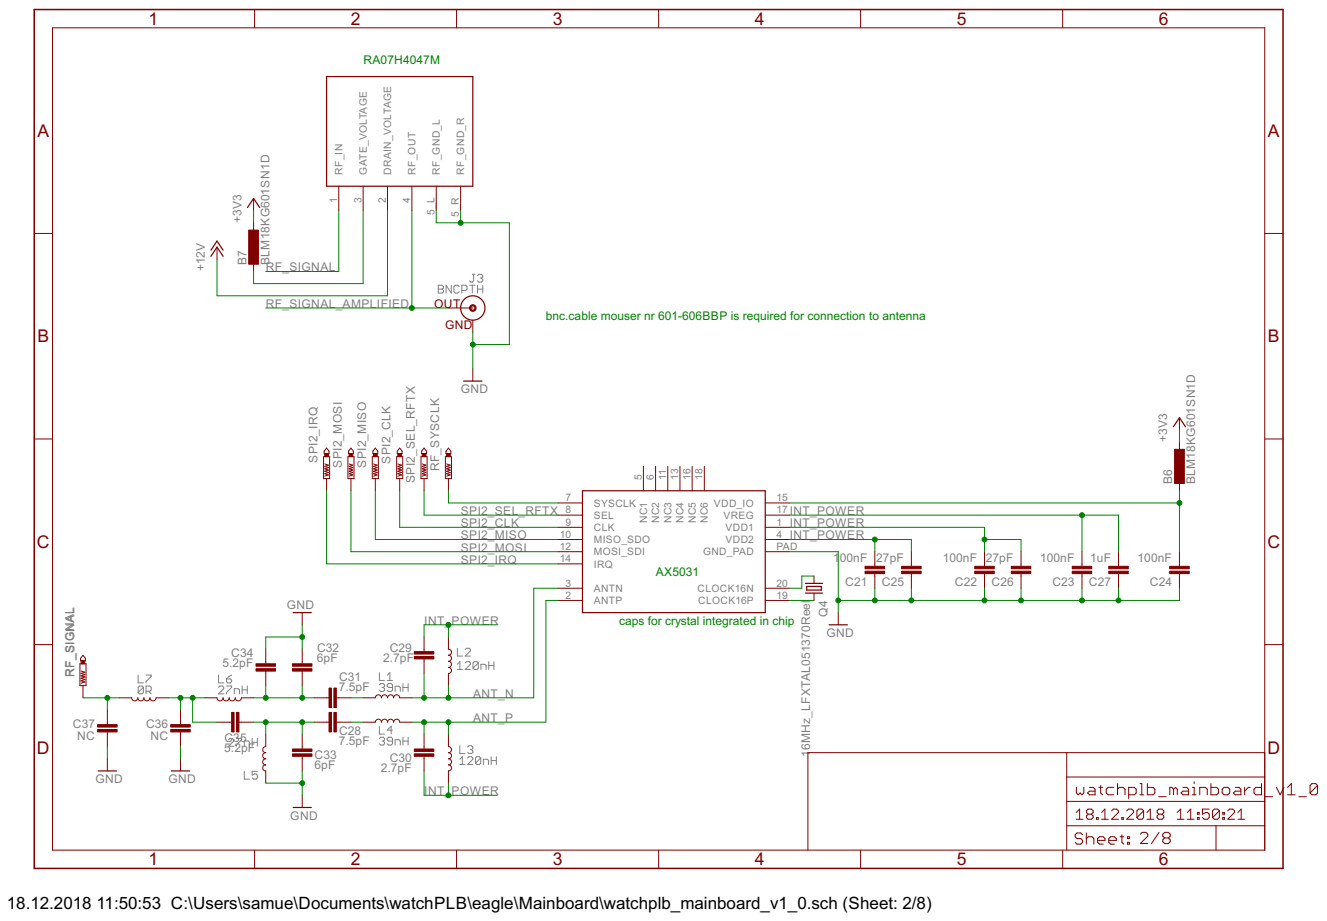
[picture p19: page 2]

bnc.cable mouser nr 601-606BBP is required for connection to antenna

caps for crystal integrated in chip

18.12.2018 11:50:53 C:\Users\samue\Documents\watchPLB\eagle\Mainboard\watchplb_mainboard_v1_0.sch (Sheet: 2/8)

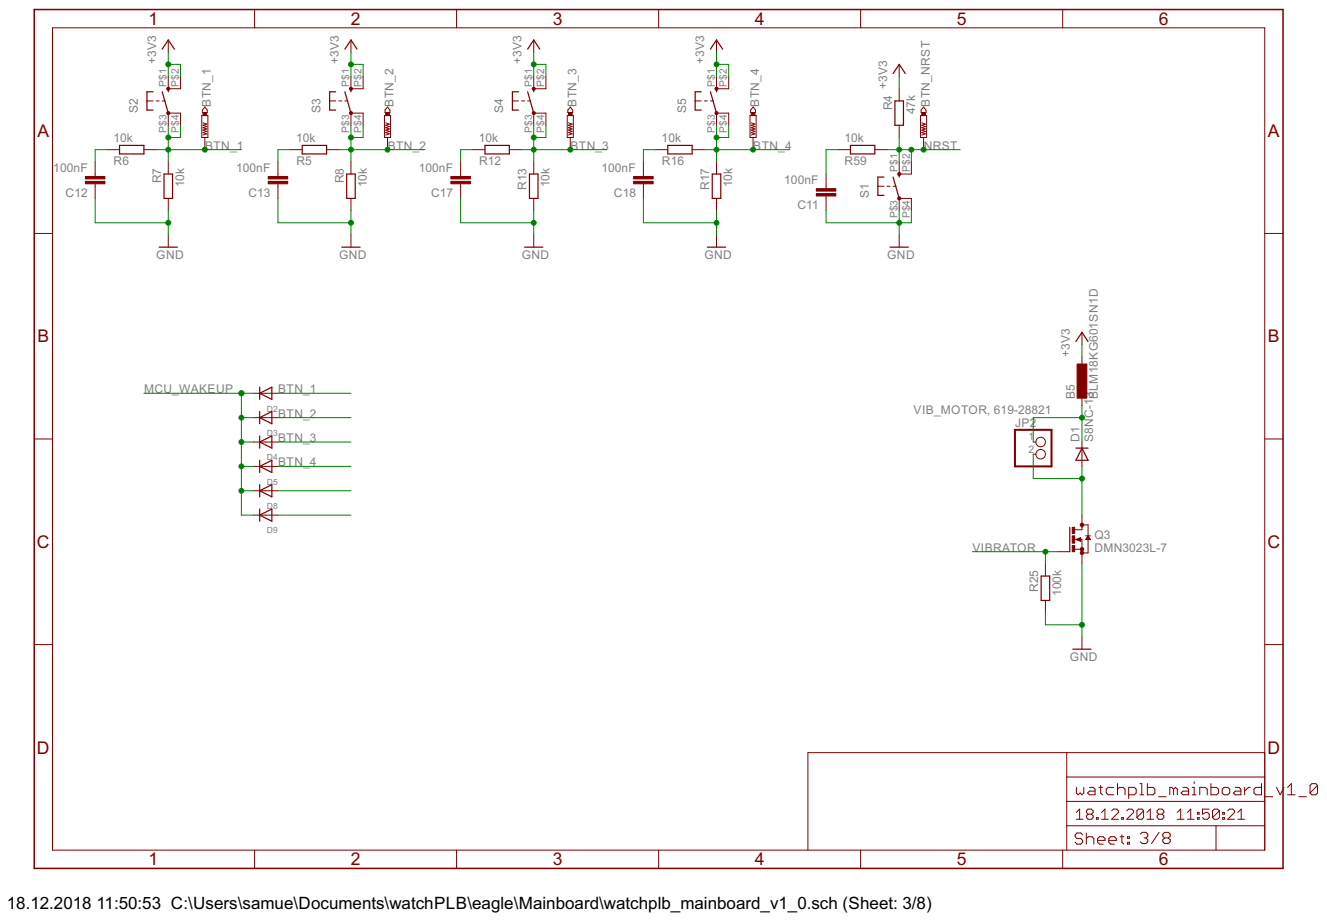
[picture p20: page 3]

18.12.2018 11:50:53 C:\Users\samue\Documents\watchPLB\eagle\Mainboard\watchplb_mainboard_v1_0.sch (Sheet: 3/8)

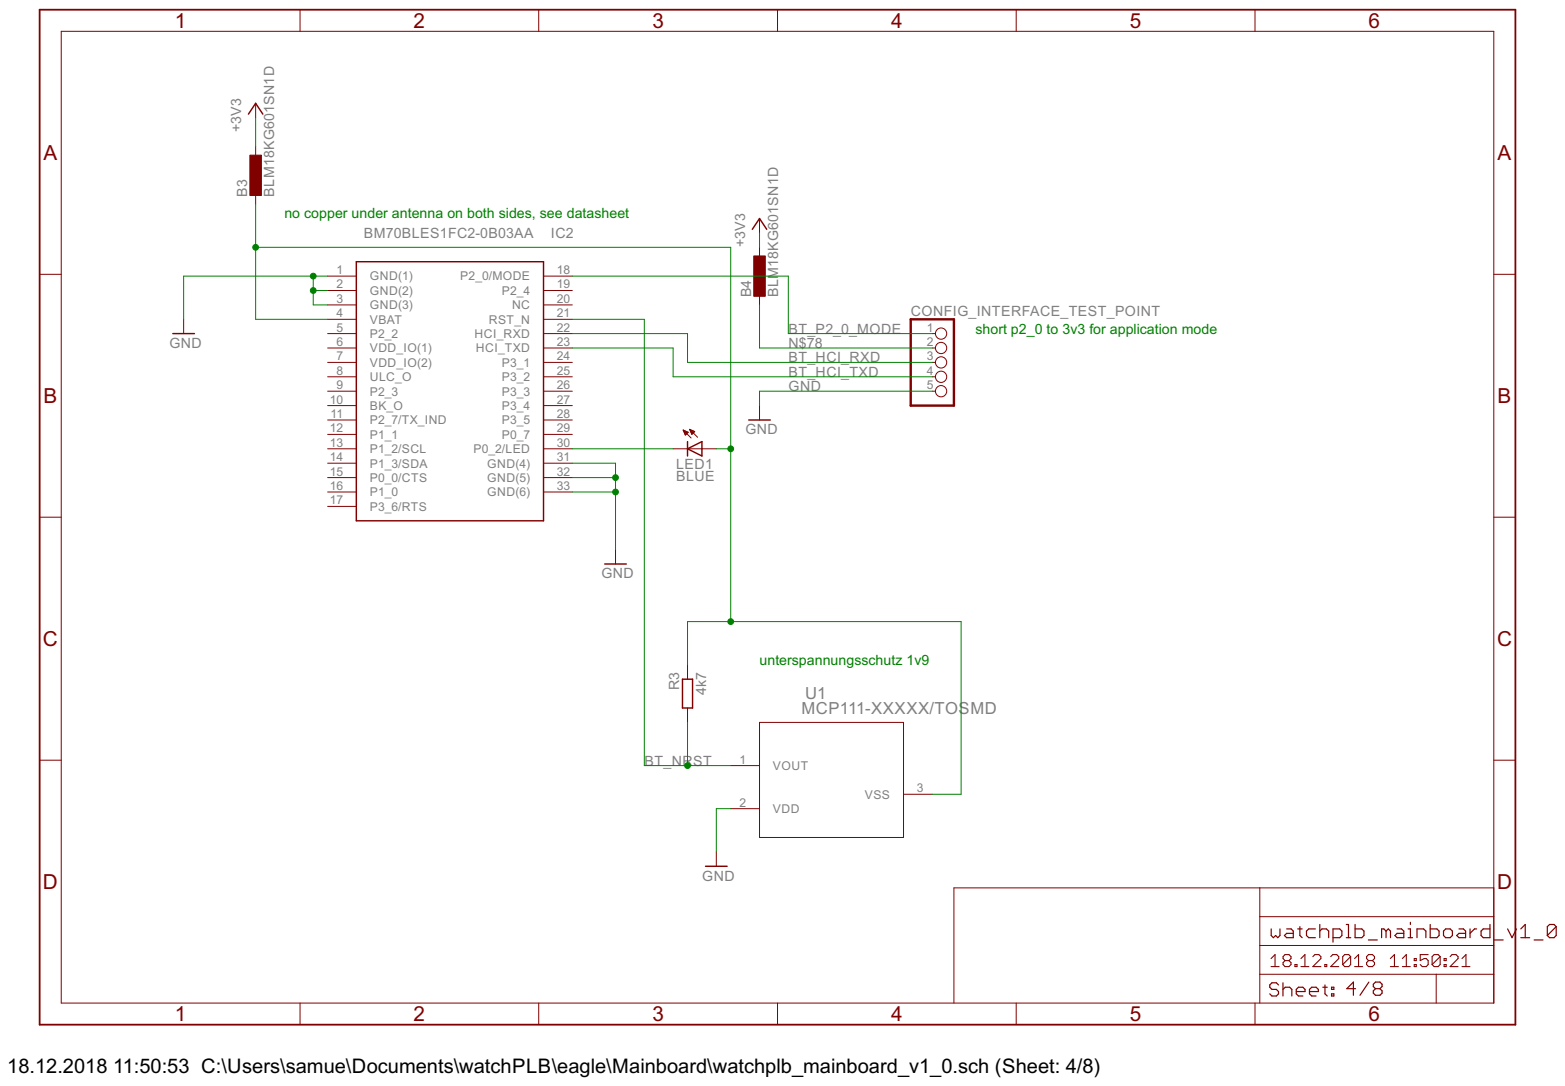
[picture p21: page 4]

no copper under antenna on both sides, see datasheet

short p2_0 to 3v3 for application mode

18.12.2018 11:50:53 C:\Users\samue\Documents\watchPLB\eagle\Mainboard\watchplb_mainboard_v1_0.sch (Sheet: 4/8)

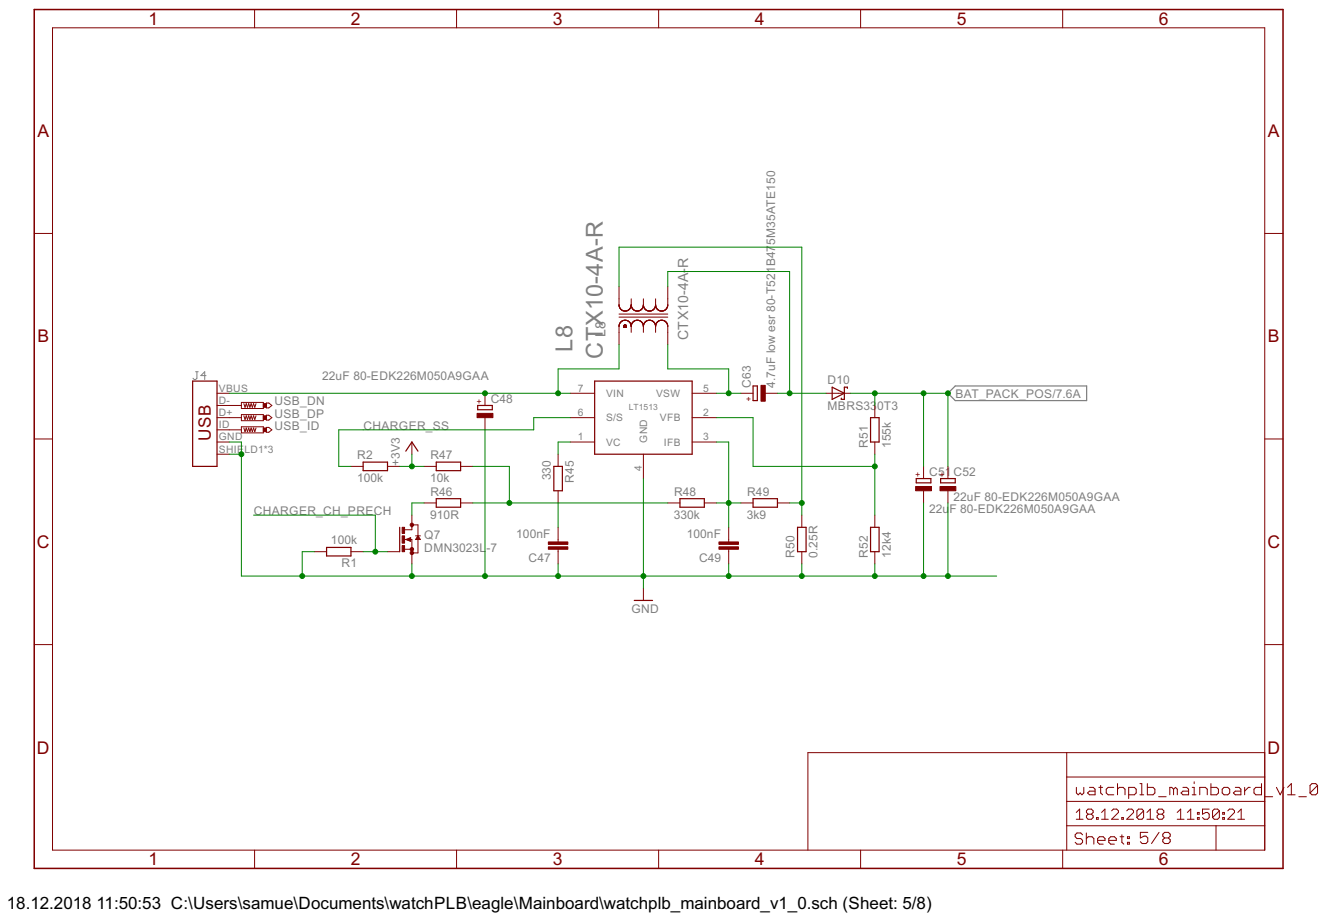
[picture p22: page 5]

18.12.2018 11:50:53 C:\Users\samue\Documents\watchPLB\eagle\Mainboard\watchplb_mainboard_v1_0.sch (Sheet: 5/8)

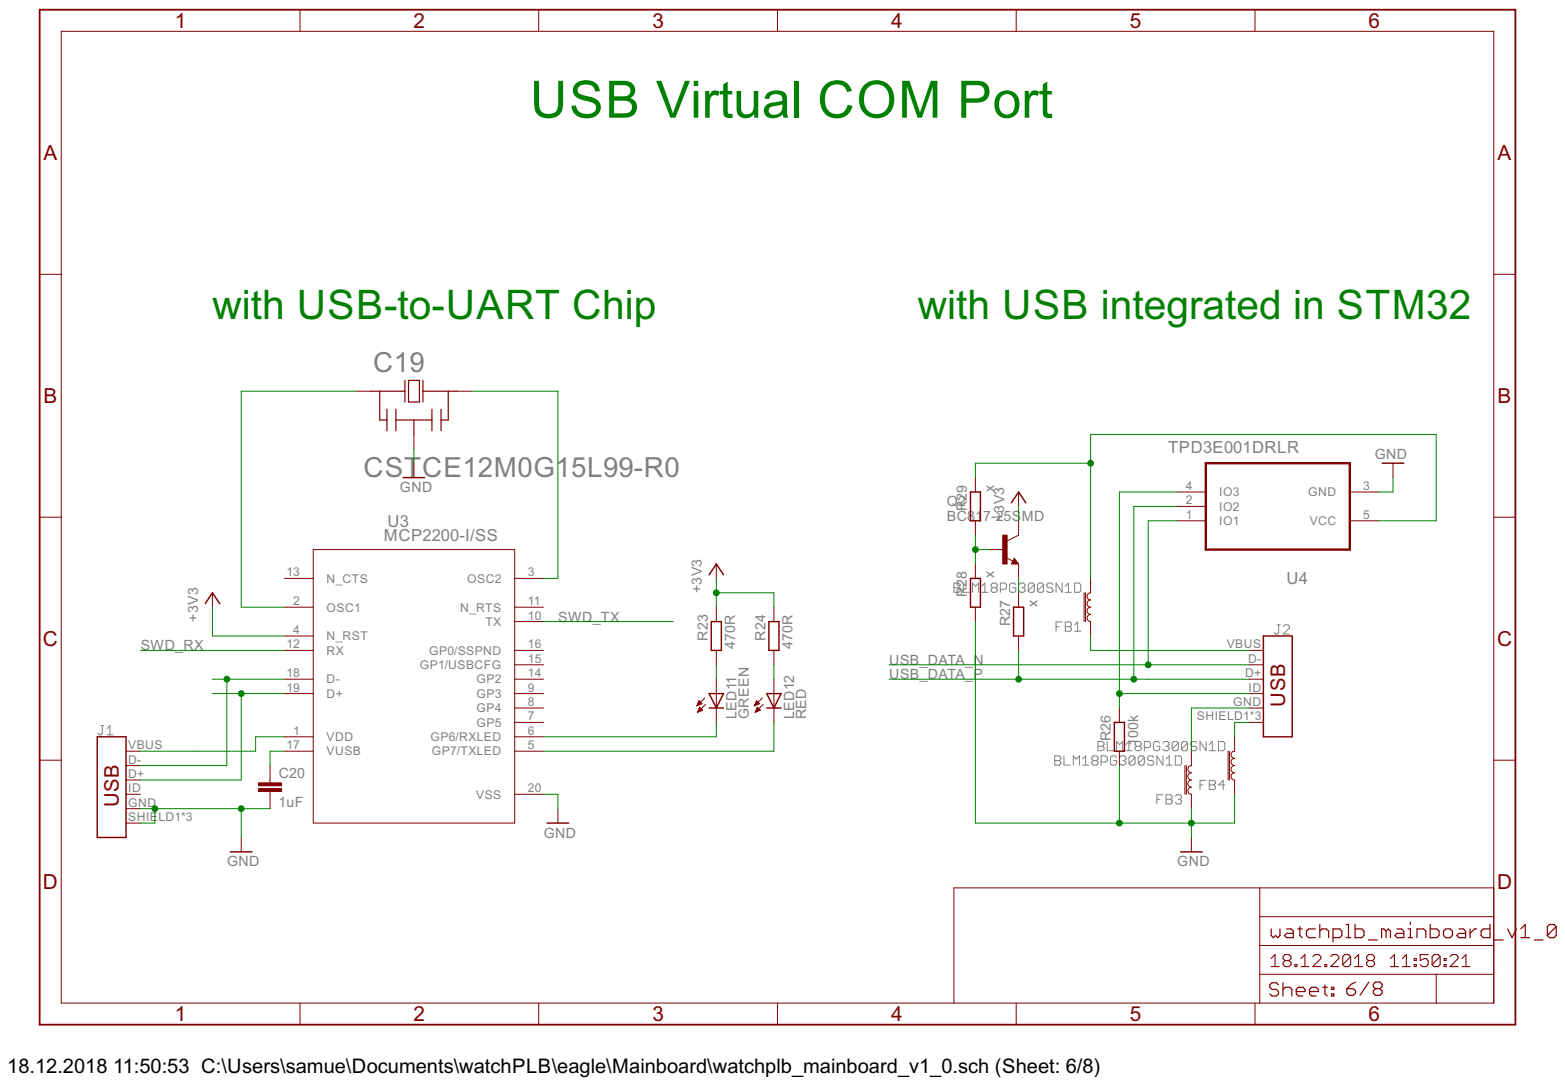
[picture p23: page 6]

USB Virtual COM Port

18.12.2018 11:50:53 C:\Users\samue\Documents\watchPLB\eagle\Mainboard\watchplb_mainboard_v1_0.sch (Sheet: 6/8)

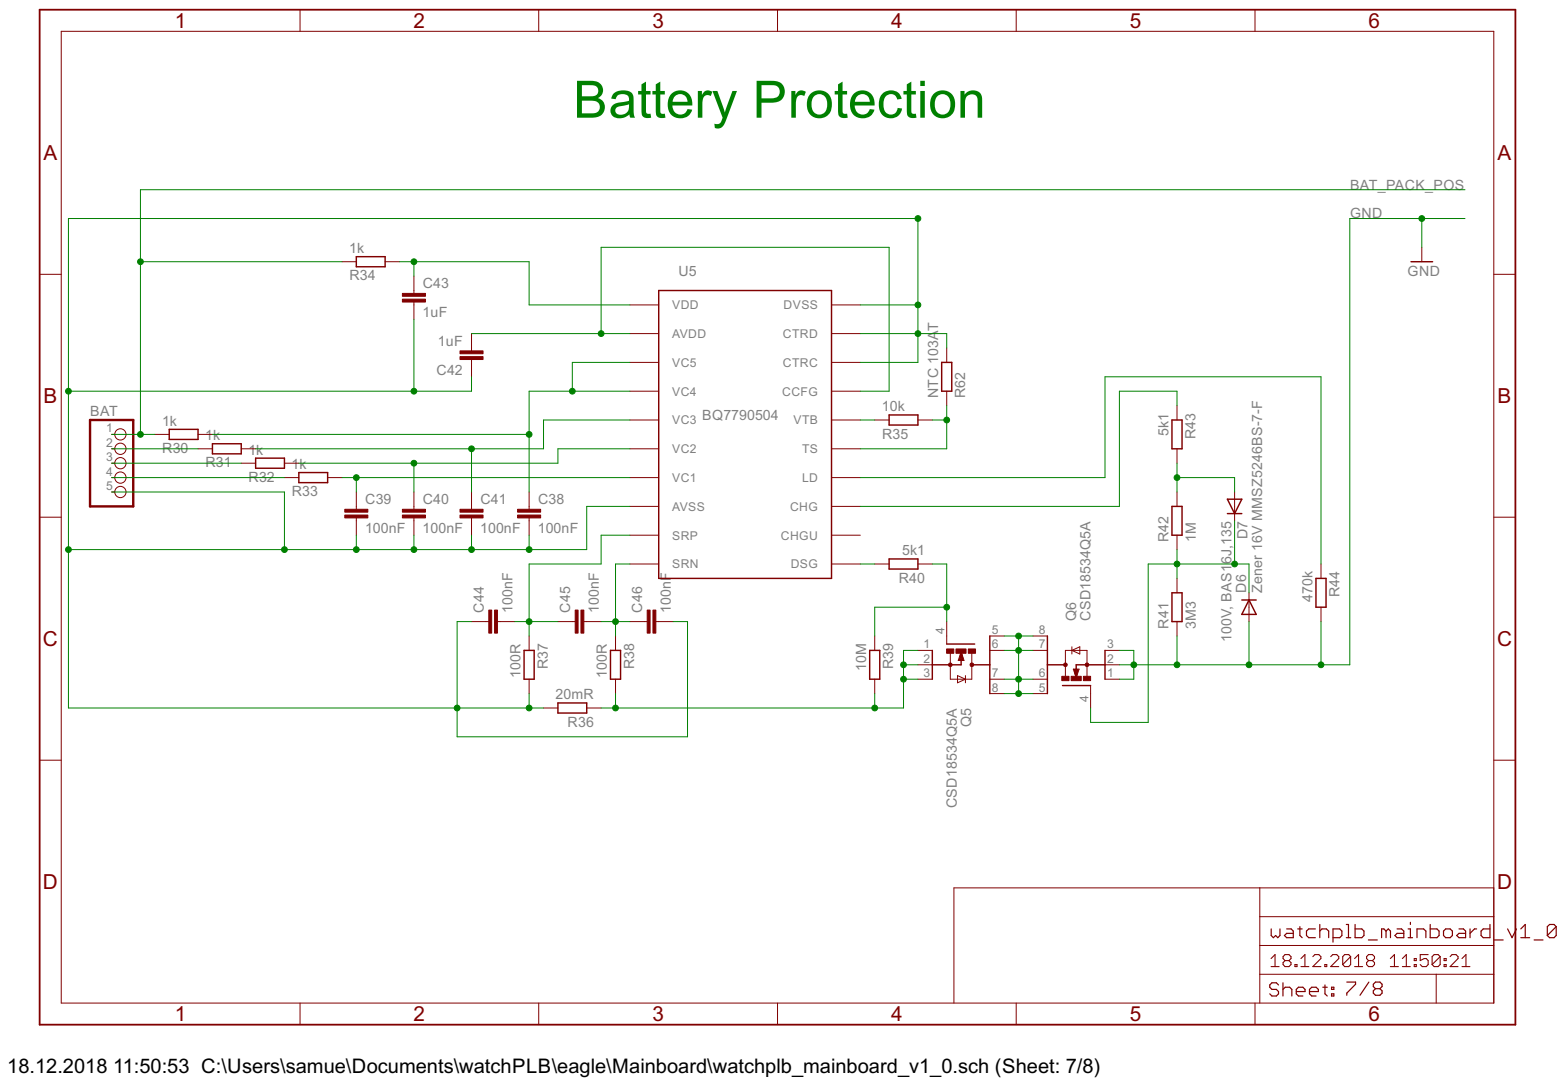
[picture p24: page 7]

18.12.2018 11:50:53 C:\Users\samue\Documents\watchPLB\eagle\Mainboard\watchplb_mainboard_v1_0.sch (Sheet: 7/8)

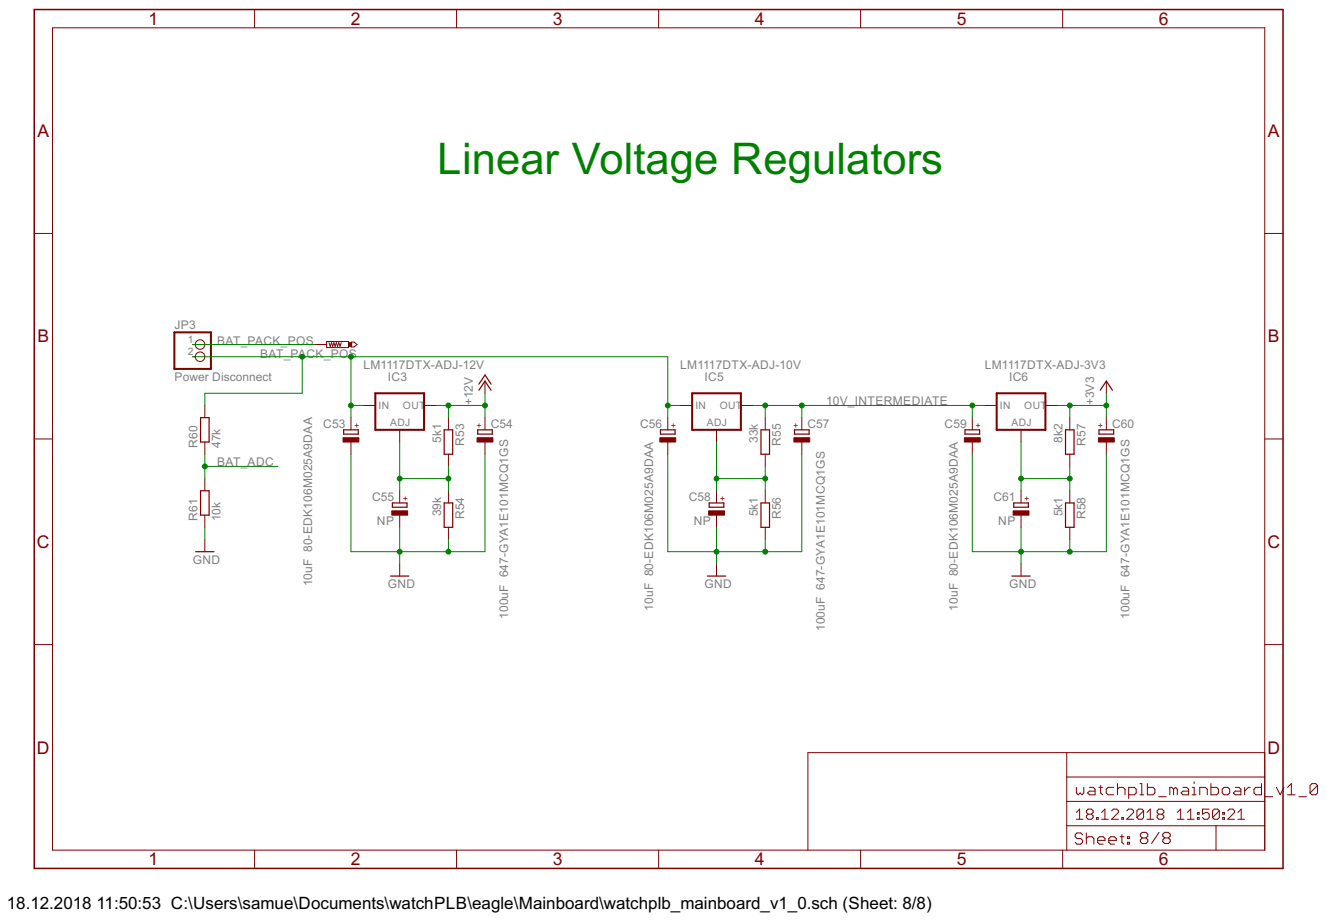
[picture p25: page 8]

18.12.2018 11:50:53 C:\Users\samue\Documents\watchPLB\eagle\Mainboard\watchplb_mainboard_v1_0.sch (Sheet: 8/8)
