crispycookies/watchPLB/eagle/GPS_board/watchplb_gps_v1_0_AB.pdf

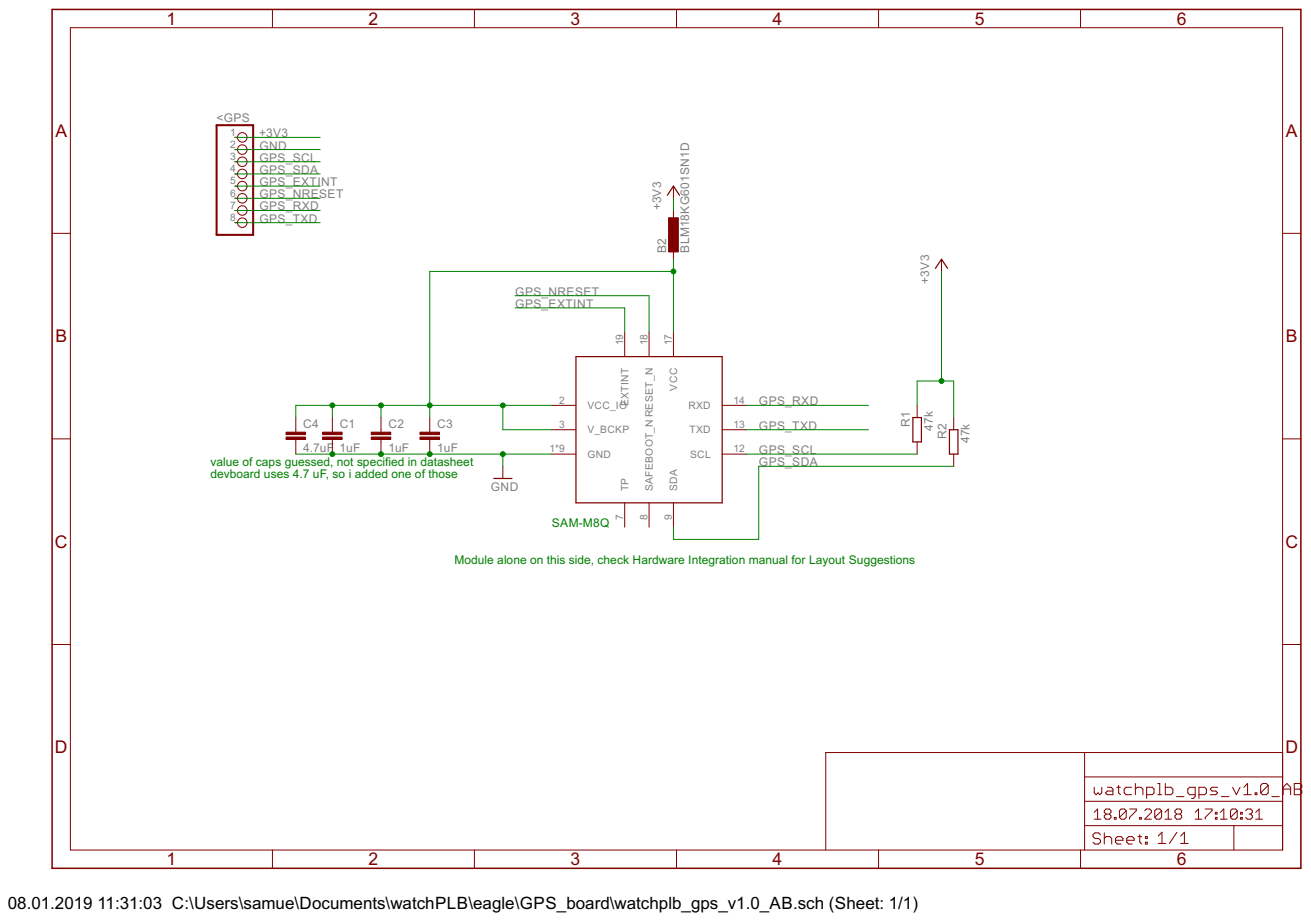
[picture p26: page 1]

value of caps guessed, not specified in datasheet

Module alone on this side, check Hardware Integration manual for Layout Suggestions

08.01.2019 11:31:03 C:\Users\samue\Documents\watchPLB\eagle\GPS_board\watchplb_gps_v1.0_AB.sch (Sheet: 1/1)
