crispycookies/watchPLB/eagle/Mainboard/watchplb_mainboard_v1_0.brd

## EAGLE design eagle/Mainboard/watchplb_mainboard_v1_0.brd (2019-01-08, an earlier design)

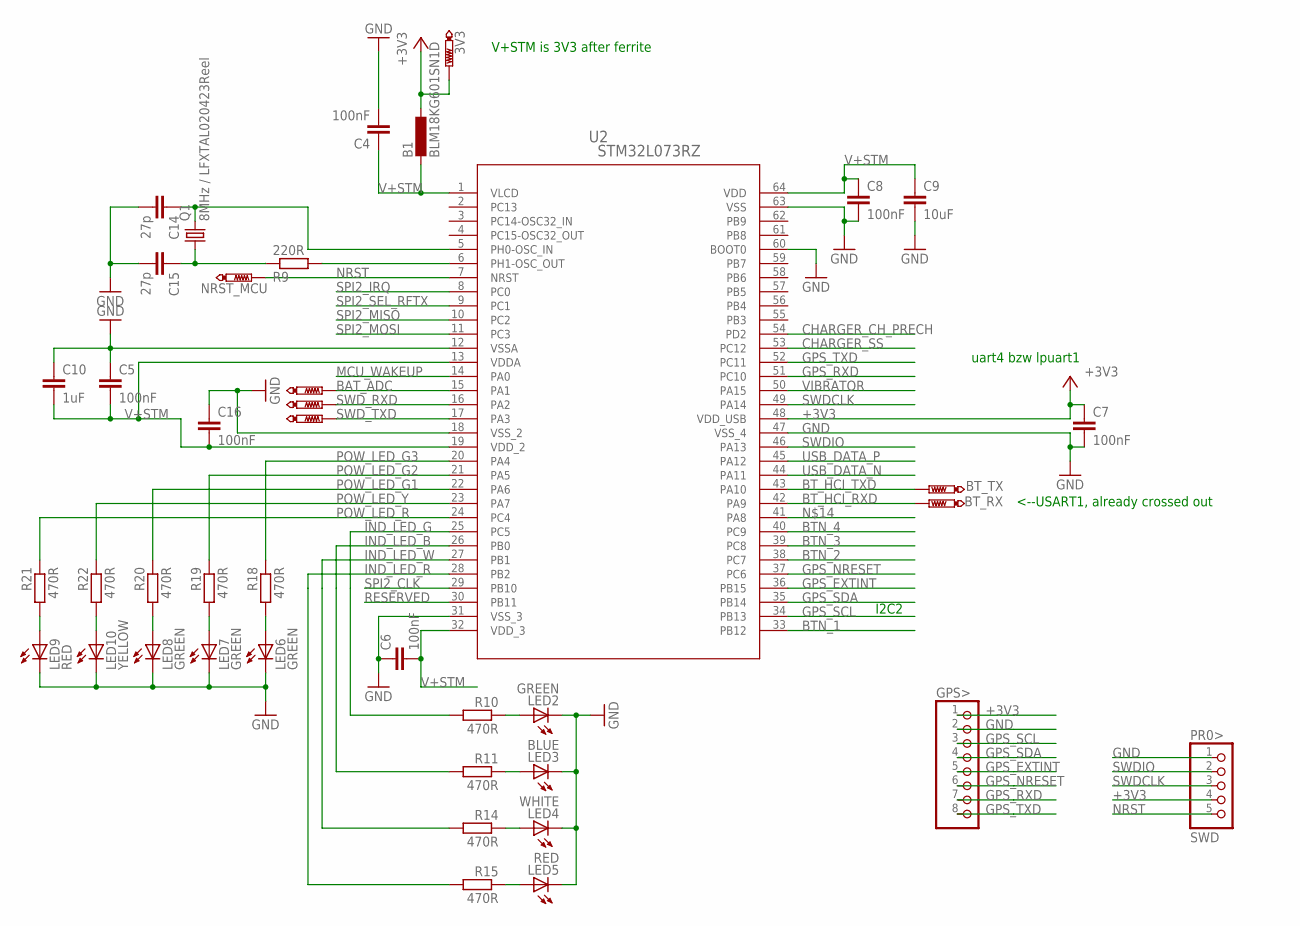
[picture p27: schematic watchplb_mainboard_v1_0.sch, sheet 1, MCU]

Parts:
3V3: PTR1B1,27; B1,27
B1: BLM18KG601SN1D; L0603
BAT_ADC: PTR1B1,27; B1,27
BT_RX: PTR1B1,27; B1,27
BT_TX: PTR1B1,27; B1,27
C4, C5, C6, C7, C8, C16: 100nF; C0805
C9: 10uF; C1206
C10: 1uF; C0805
C14, C15: 27p; C0805
GPS>: PINHD-1X8; 1X08
LED2, LED6, LED7, LED8: GREEN; CHIP-LED0805
LED3: BLUE; CHIP-LED0805
LED4: WHITE; CHIP-LED0805
LED5, LED9: RED; CHIP-LED0805
LED10: YELLOW; CHIP-LED0805
NRST_MCU: PTR1B1,27; B1,27
PR0>: SWD; 1X05
Q1: 8MHz / LFXTAL020423Reel; HC49UP
R9: 220R; M0805
R10, R11, R14, R15, R18, R19, R20, R21, R22: 470R; M0805
SWD_RXD: PTR1B1,27; B1,27
SWD_TXD: PTR1B1,27; B1,27
U2: STM32L073RZ; LQFP64-10X10MM

Connections:
+3V3: 3V3.TP, B1.1, C7.1, GPS>.1, PR0>.4, U2.48 (VDD_USB); also elsewhere on the board
BAT_ADC: BAT_ADC.TP, U2.15 (PA1); also elsewhere on the board
BTN_1: U2.33 (PB12); also elsewhere on the board
BTN_2: U2.38 (PC7); also elsewhere on the board
BTN_3: U2.39 (PC8); also elsewhere on the board
BTN_4: U2.40 (PC9); also elsewhere on the board
BT_HCI_RXD: BT_RX.TP, U2.42 (PA9); also elsewhere on the board
BT_HCI_TXD: BT_TX.TP, U2.43 (PA10); also elsewhere on the board
CHARGER_CH_PRECH: U2.54 (PD2); also elsewhere on the board
CHARGER_SS: U2.53 (PC12); also elsewhere on the board
GND: C4.2, C5.1, C6.1, C7.2, C8.2, C9.2, C10.1, C14.2, C15.2, C16.1, GPS>.2, LED2.C, LED3.C, LED4.C, LED5.C, LED6.C, LED7.C, LED8.C, LED9.C, LED10.C, PR0>.1, U2.12 (VSSA), U2.18 (VSS_2), U2.31 (VSS_3), U2.47 (VSS_4), U2.60 (BOOT0), U2.63 (VSS); also elsewhere on the board
GPS_EXTINT: GPS>.5, U2.36 (PB15)
GPS_NRESET: GPS>.6, U2.37 (PC6)
GPS_RXD: GPS>.7, U2.51 (PC10)
GPS_SCL: GPS>.3, U2.34 (PB13)
GPS_SDA: GPS>.4, U2.35 (PB14)
GPS_TXD: GPS>.8, U2.52 (PC11)
IND_LED_B: R11.2, U2.26 (PB0)
IND_LED_G: R10.2, U2.25 (PC5)
IND_LED_R: R15.2, U2.28 (PB2)
IND_LED_W: R14.2, U2.27 (PB1)
MCU_WAKEUP: U2.14 (PA0); also elsewhere on the board
unnamed: LED2.A, R10.1
unnamed: LED3.A, R11.1
unnamed: C15.1, Q1.1, R9.1
unnamed: C14.1, Q1.2, U2.5 (PH0-OSC_IN)
unnamed: R9.2, U2.6 (PH1-OSC_OUT)
unnamed: LED4.A, R14.1
unnamed: LED9.A, R21.2
unnamed: LED5.A, R15.1
unnamed: LED6.A, R18.2
unnamed: LED7.A, R19.2
unnamed: LED10.A, R22.2
unnamed: LED8.A, R20.2
NRST: NRST_MCU.TP, PR0>.5, U2.7 (NRST); also elsewhere on the board
POW_LED_G1: R20.1, U2.22 (PA6)
POW_LED_G2: R19.1, U2.21 (PA5)
POW_LED_G3: R18.1, U2.20 (PA4)
POW_LED_R: R21.1, U2.24 (PC4)
POW_LED_Y: R22.1, U2.23 (PA7)
RESERVED: U2.30 (PB11)
SPI2_CLK: U2.29 (PB10); also elsewhere on the board
SPI2_IRQ: U2.8 (PC0); also elsewhere on the board
SPI2_MISO: U2.10 (PC2); also elsewhere on the board
SPI2_MOSI: U2.11 (PC3); also elsewhere on the board
SPI2_SEL_RFTX: U2.9 (PC1); also elsewhere on the board
SWDCLK: PR0>.3, U2.49 (PA14)
SWDIO: PR0>.2, U2.46 (PA13)
SWD_RXD: SWD_RXD.TP, U2.16 (PA2)
SWD_TXD: SWD_TXD.TP, U2.17 (PA3)
USB_DATA_N: U2.44 (PA11); also elsewhere on the board
USB_DATA_P: U2.45 (PA12); also elsewhere on the board
V+STM: B1.2, C4.1, C5.2, C6.2, C8.1, C9.1, C10.2, C16.2, U2.1 (VLCD), U2.13 (VDDA), U2.19 (VDD_2), U2.32 (VDD_3), U2.64 (VDD)
VIBRATOR: U2.50 (PA15); also elsewhere on the board

Notes on the sheet:
<--USART1, already crossed out
I2C2
uart4 bzw lpuart1
V+STM is 3V3 after ferrite

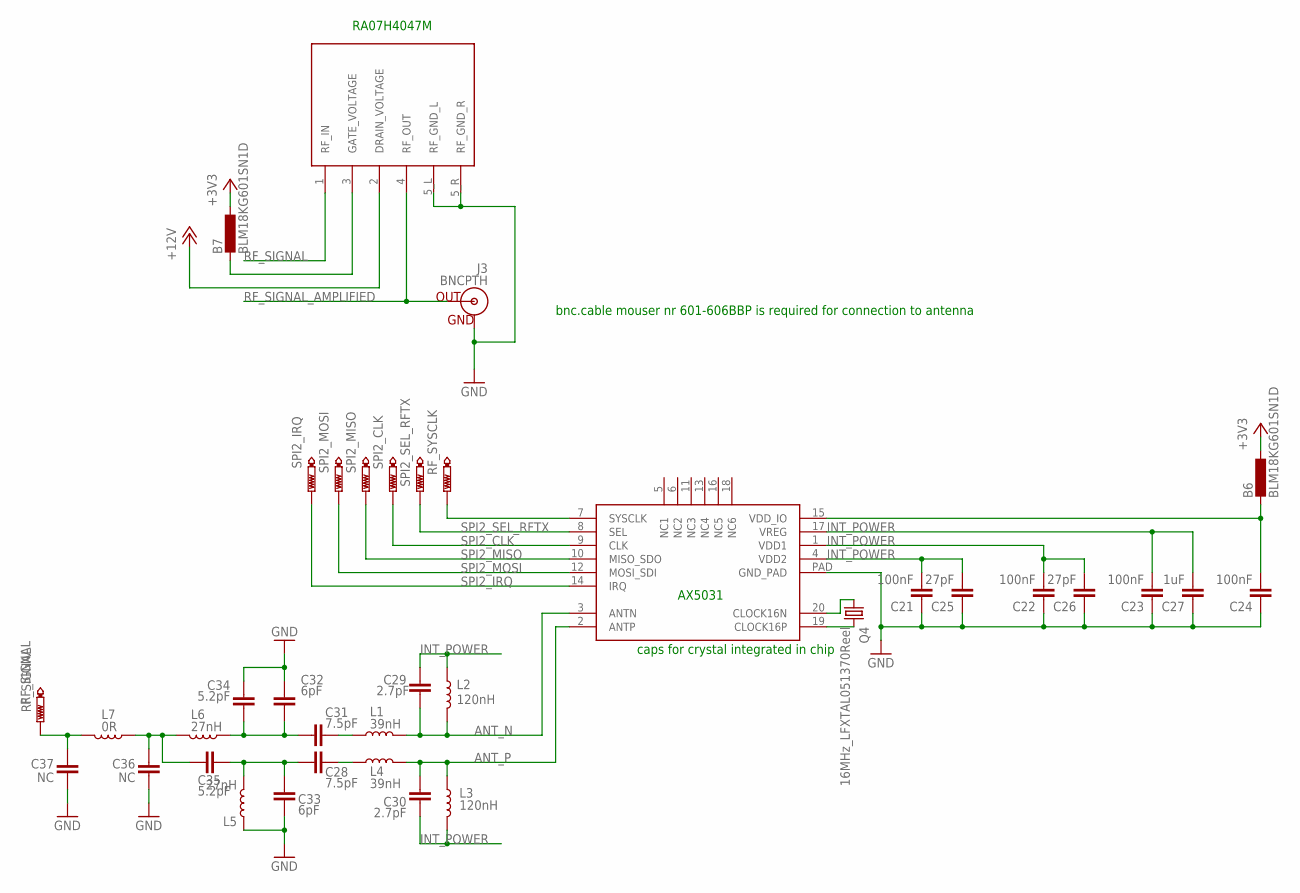
[picture p28: schematic watchplb_mainboard_v1_0.sch, sheet 2, FUNK]

Parts:
B6, B7: BLM18KG601SN1D; L0603
C21, C22, C23, C24: 100nF; C0805
C25, C26: 27pF; C0805
C27: 1uF; C0805
C28, C31: 7.5pF; C0805
C29, C30: 2.7pF; C0805
C32, C33: 6pF; C0805
C34, C35: 5.2pF; C0805
C36, C37: NC; C0805
IC4: AX5031; QFN20
J3: BNCPTH; BNC
L1, L4: 39nH; 0805
L2, L3: 120nH; 0805
L5, L6: 27nH; 0805
L7: 0R; 0805
Q4: 16MHz_LFXTAL051370Reel; HC49UP
RF_SIGNAL: PTR1B2,54; B2,54
RF_SYSCLK: PTR1B1,27; B1,27
SPI2_CLK, SPI2_IRQ, SPI2_MISO, SPI2_MOSI, SPI2_SEL_RFTX: PTR1B1,27; B1,27
U$2: RA07H4047M

Connections:
+3V3: B6.1, B7.1; also elsewhere on the board
+12V: U$2.2 (DRAIN_VOLTAGE); also elsewhere on the board
ANT_N: C29.1, IC4.3 (ANTN), L1.2, L2.2
ANT_P: C30.2, IC4.2 (ANTP), L3.1, L4.2
GND: C21.1, C22.1, C23.1, C24.1, C25.1, C26.1, C27.1, C32.1, C33.2, C34.1, C36.1, C37.1, IC4.PAD (GND_PAD), J3.GND, L5.1, U$2.5_L (RF_GND_L), U$2.5_R (RF_GND_R); also elsewhere on the board
INT_POWER: C21.2, C22.2, C23.2, C25.2, C26.2, C27.2, C29.2, C30.1, IC4.1 (VDD1), IC4.4 (VDD2), IC4.17 (VREG), L2.1, L3.2
unnamed: IC4.19 (CLOCK16P), Q4.2
unnamed: IC4.20 (CLOCK16N), Q4.1
unnamed: IC4.7 (SYSCLK), RF_SYSCLK.TP
unnamed: C28.1, L4.1
unnamed: C31.1, L1.1
unnamed: C31.2, C32.2, C34.2, L6.1
unnamed: C28.2, C33.1, C35.2, L5.2
unnamed: C35.1, C36.2, L6.2, L7.1
unnamed: B6.2, C24.2, IC4.15 (VDD_IO)
unnamed: B7.2, U$2.3 (GATE_VOLTAGE)
RF_SIGNAL: C37.2, L7.2, RF_SIGNAL.TP, U$2.1 (RF_IN)
RF_SIGNAL_AMPLIFIED: J3.S (OUT), U$2.4 (RF_OUT)
SPI2_CLK: IC4.9 (CLK), SPI2_CLK.TP; also elsewhere on the board
SPI2_IRQ: IC4.14 (IRQ), SPI2_IRQ.TP; also elsewhere on the board
SPI2_MISO: IC4.10 (MISO_SDO), SPI2_MISO.TP; also elsewhere on the board
SPI2_MOSI: IC4.12 (MOSI_SDI), SPI2_MOSI.TP; also elsewhere on the board
SPI2_SEL_RFTX: IC4.8 (SEL), SPI2_SEL_RFTX.TP; also elsewhere on the board

Notes on the sheet:
caps for crystal integrated in chip
bnc.cable mouser nr 601-606BBP is required for connection to antenna
AX5031
RA07H4047M

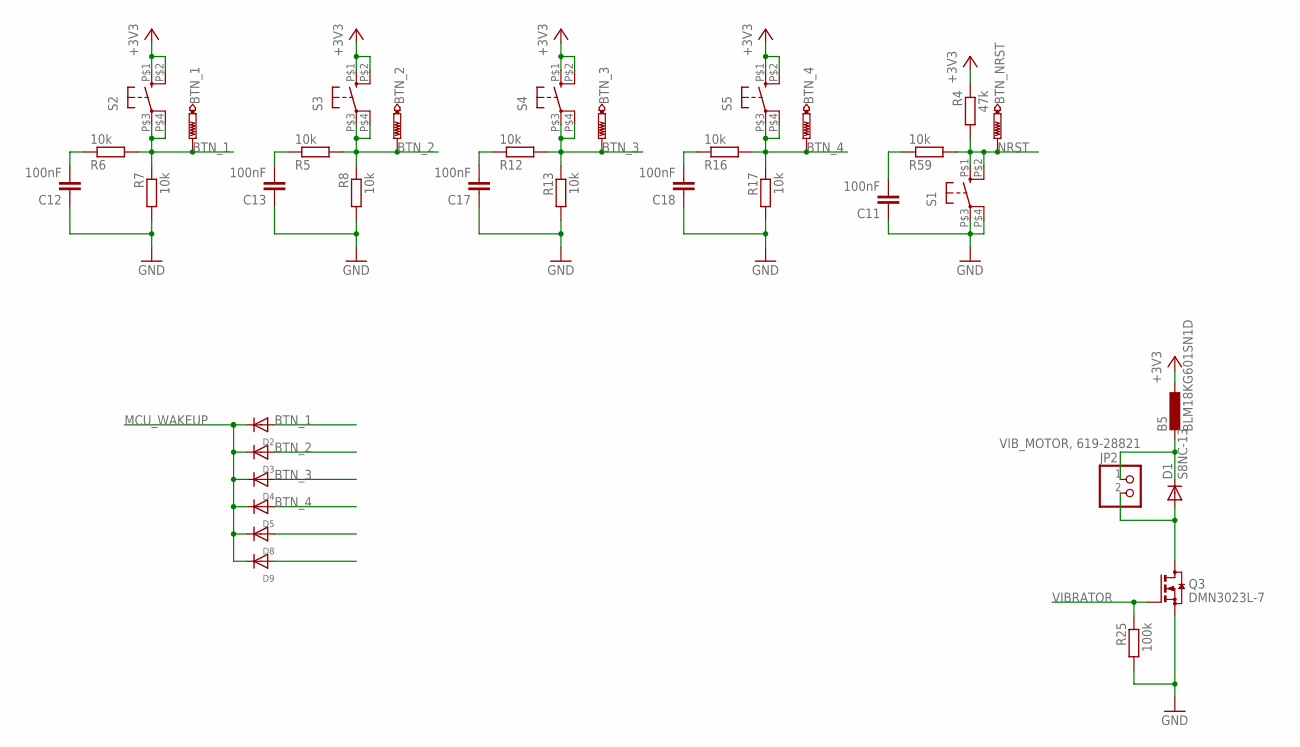
[picture p29: schematic watchplb_mainboard_v1_0.sch, sheet 3, BTN]

Parts:
B5: BLM18KG601SN1D; L0603
BTN_1, BTN_2, BTN_3, BTN_4: PTR1B1,27; B1,27
BTN_NRST: PTR1B1,27; B1,27
C11, C12, C13, C17, C18: 100nF; C0805
D1: S8NC-13; SMC
D2, D3, D4, D5, D8, D9: DIODESOD-123; SOD-123
JP2: VIB_MOTOR, 619-28821; 1X02
Q3: DMN3023L-7; SOT23
R4: 47k; M0805
R5, R6, R7, R8, R12, R13, R16, R17, R59: 10k; M0805
R25: 100k; M0805
S1, S2, S3, S4, S5: TL3305; SMD_SWITCH

Connections:
+3V3: B5.1, R4.1, S2.P$1 (SL1), S2.P$2 (SL2), S3.P$1 (SL1), S3.P$2 (SL2), S4.P$1 (SL1), S4.P$2 (SL2), S5.P$1 (SL1), S5.P$2 (SL2); also elsewhere on the board
BTN_1: BTN_1.TP, D2.A, R6.2, R7.1, S2.P$3 (SR1), S2.P$4 (SR2); also elsewhere on the board
BTN_2: BTN_2.TP, D3.A, R5.2, R8.1, S3.P$3 (SR1), S3.P$4 (SR2); also elsewhere on the board
BTN_3: BTN_3.TP, D4.A, R12.2, R13.1, S4.P$3 (SR1), S4.P$4 (SR2); also elsewhere on the board
BTN_4: BTN_4.TP, D5.A, R16.2, R17.1, S5.P$3 (SR1), S5.P$4 (SR2); also elsewhere on the board
GND: C11.1, C12.1, C13.1, C17.1, C18.1, Q3.2 (S), R7.2, R8.2, R13.2, R17.2, R25.2, S1.P$3 (SR1), S1.P$4 (SR2); also elsewhere on the board
MCU_WAKEUP: D2.C, D3.C, D4.C, D5.C, D8.C, D9.C; also elsewhere on the board
unnamed: C12.2, R6.1
unnamed: C13.2, R5.1
unnamed: C17.2, R12.1
unnamed: C18.2, R16.1
unnamed: D1.A, JP2.2, Q3.3 (D)
unnamed: B5.2, D1.C, JP2.1
unnamed: C11.2, R59.1
NRST: BTN_NRST.TP, R4.2, R59.2, S1.P$1 (SL1), S1.P$2 (SL2); also elsewhere on the board
VIBRATOR: Q3.1 (G), R25.1; also elsewhere on the board

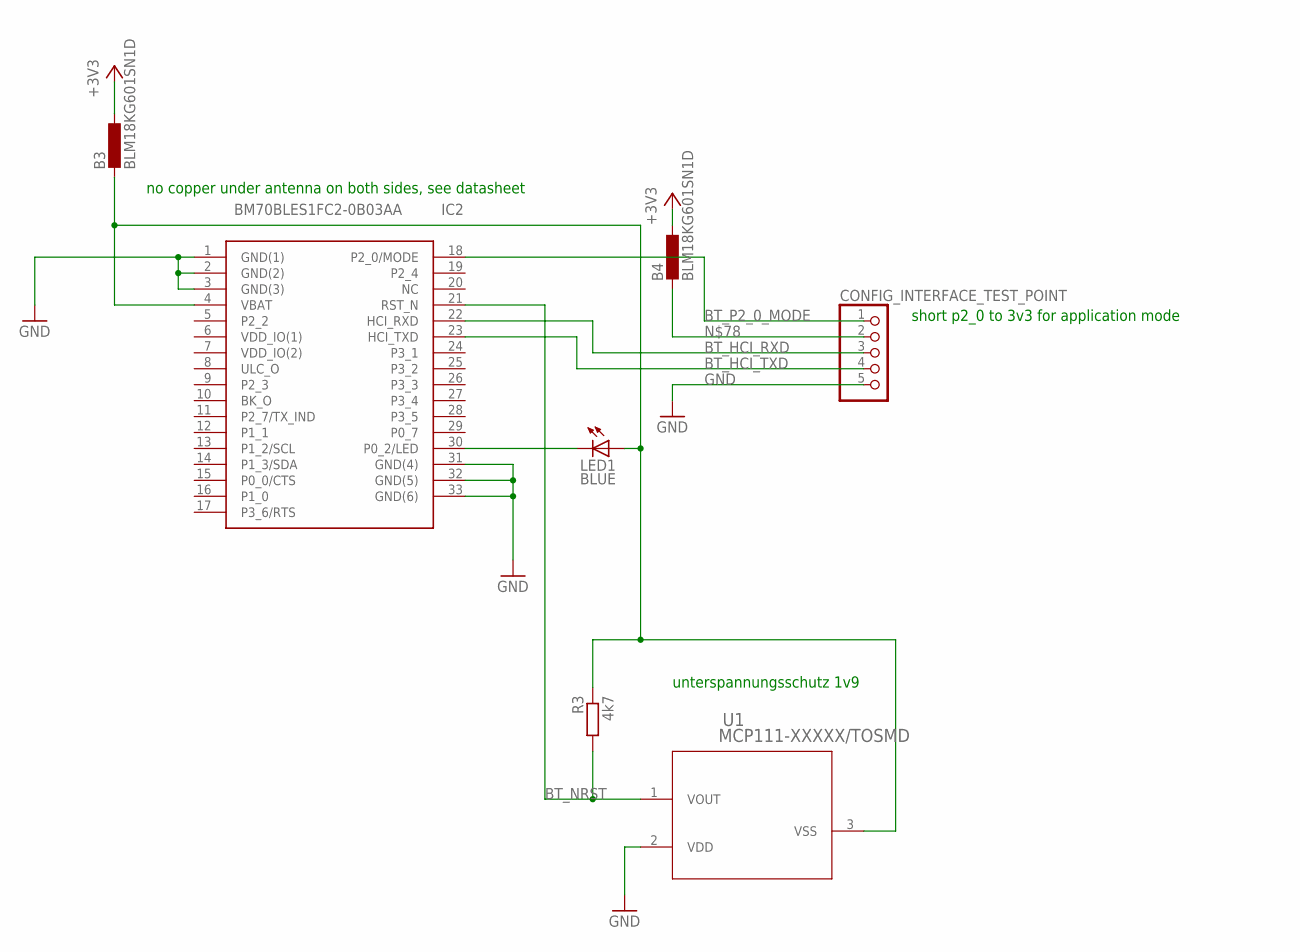
[picture p30: schematic watchplb_mainboard_v1_0.sch, sheet 4, BT]

Parts:
B3, B4: BLM18KG601SN1D; L0603
CONFIG_INTERFACE_TEST_POINT: PINHD-1X5; 1X05
IC2: BM70BLES1FC2-0B03AA; BM78SPPS5NC2_1
LED1: BLUE; CHIP-LED0805
R3: 4k7; M0805
U1: MCP111-XXXXX/TOSMD; SC70-3-R

Connections:
+3V3: B3.1, B4.1; also elsewhere on the board
BT_HCI_RXD: CONFIG_INTERFACE_TEST_POINT.3, IC2.22 (HCI_RXD); also elsewhere on the board
BT_HCI_TXD: CONFIG_INTERFACE_TEST_POINT.4, IC2.23 (HCI_TXD); also elsewhere on the board
BT_NRST: IC2.21 (RST_N), R3.2, U1.1 (VOUT)
BT_P2_0_MODE: CONFIG_INTERFACE_TEST_POINT.1, IC2.18 (P2_0/MODE)
GND: CONFIG_INTERFACE_TEST_POINT.5, IC2.1 (GND(1)), IC2.2 (GND(2)), IC2.3 (GND(3)), IC2.31 (GND(4)), IC2.32 (GND(5)), IC2.33 (GND(6)), U1.2 (VDD); also elsewhere on the board
unnamed: IC2.30 (P0_2/LED), LED1.C
unnamed: B4.2, CONFIG_INTERFACE_TEST_POINT.2
unnamed: B3.2, IC2.4 (VBAT), LED1.A, R3.1, U1.3 (VSS)

Notes on the sheet:
unterspannungsschutz 1v9
no copper under antenna on both sides, see datasheet
short p2_0 to 3v3 for application mode

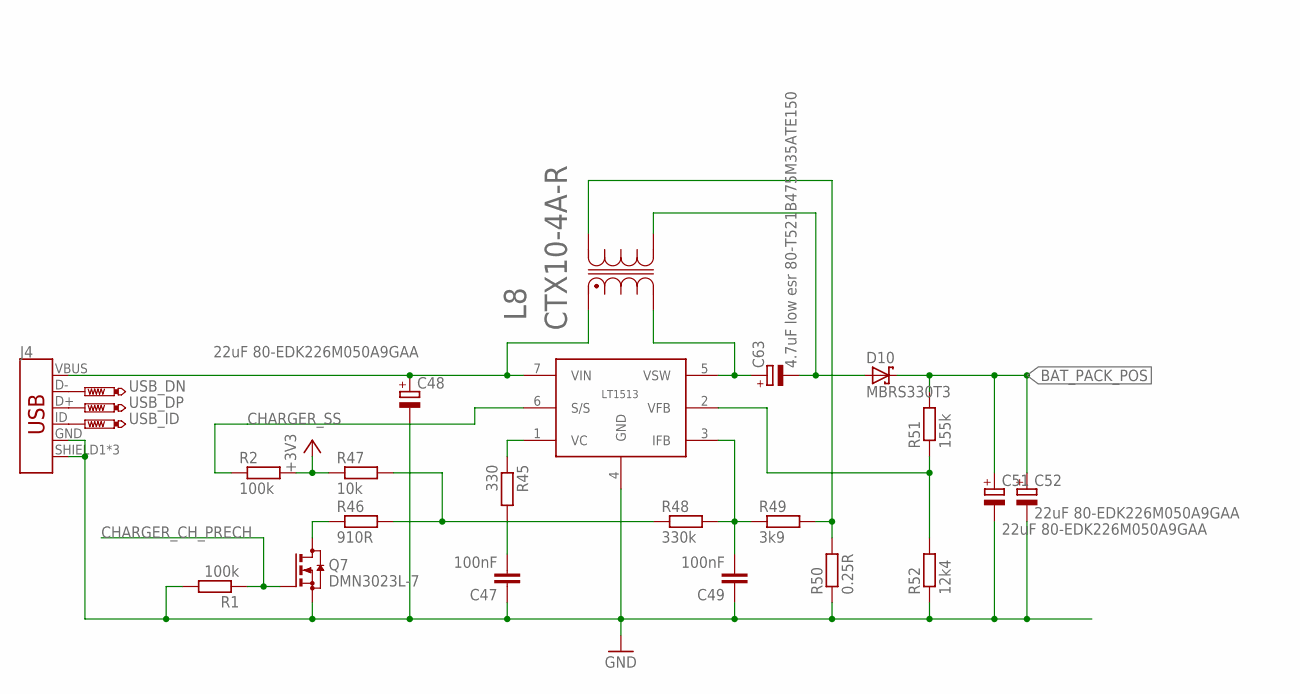
[picture p31: schematic watchplb_mainboard_v1_0.sch, sheet 5, CHG]

Parts:
C47, C49: 100nF; C0805K
C48, C51, C52: 22uF 80-EDK226M050A9GAA; PANASONIC_E
C63: 4.7uF low esr 80-T521B475M35ATE150; B/3528-21R
D10: MBRS330T3; SMC
IC1: LT1513; TO220-7
J4: USB_MICRO-B_FEMALE-SMT; USB-B-MICRO-SMD
L8: CTX10-4A-R; INDM115115X635N
Q7: DMN3023L-7; SOT23
R1, R2: 100k; M0805
R45: 330; M0805
R46: 910R; M0805
R47: 10k; M0805
R48: 330k; M0805
R49: 3k9; M0805
R50: 0.25R; R2512
R51: 155k; M0805
R52: 12k4; M0805
USB_DN: PTR1B1,27; B1,27
USB_DP: PTR1B1,27; B1,27
USB_ID: PTR1B1,27; B1,27

Connections:
+3V3: R2.2, R47.1; also elsewhere on the board
BAT_PACK_POS: C51.+, C52.+, D10.C, R51.2; also elsewhere on the board
CHARGER_CH_PRECH: Q7.1 (G), R1.1; also elsewhere on the board
CHARGER_SS: IC1.6 (S/S), R2.1; also elsewhere on the board
GND: C47.1, C48.-, C49.1, C51.-, C52.-, IC1.4 (GND), J4.GND, J4.SHIELD1 (SHIELD), J4.SHIELD2 (SHIELD), J4.SHIELD3 (SHIELD), Q7.2 (S), R1.2, R50.1, R52.1; also elsewhere on the board
unnamed: C63.+, IC1.5 (VSW), L8.2
unnamed: C48.+, IC1.7 (VIN), J4.VBUS, L8.1
unnamed: L8.4, R49.2, R50.2
unnamed: C47.2, R45.2
unnamed: IC1.1 (VC), R45.1
unnamed: Q7.3 (D), R46.1
unnamed: R46.2, R47.2, R48.1
unnamed: C49.2, IC1.3 (IFB), R48.2, R49.1
unnamed: IC1.2 (VFB), R51.1, R52.2
unnamed: J4.ID, USB_ID.TP
unnamed: J4.D+, USB_DP.TP
unnamed: J4.D-, USB_DN.TP
unnamed: C63.-, D10.A, L8.3

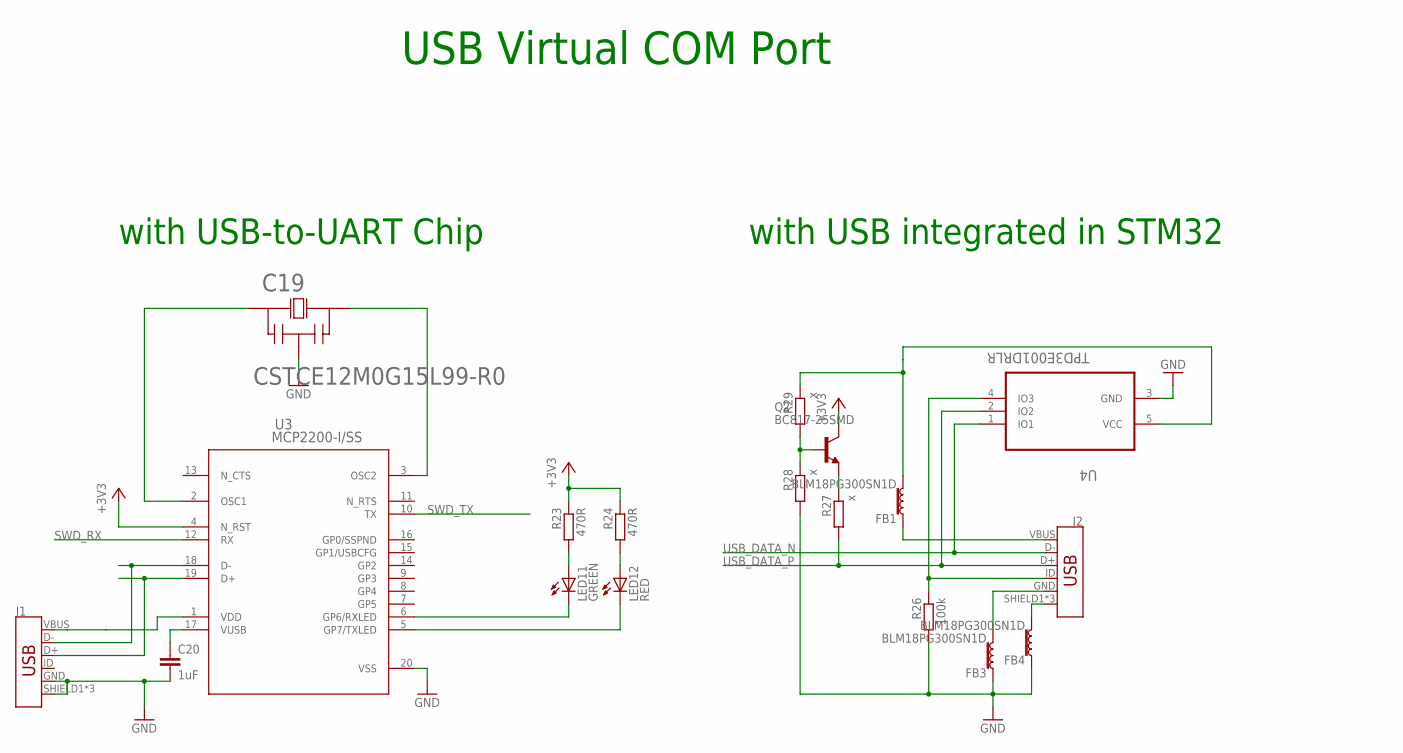
[picture p32: schematic watchplb_mainboard_v1_0.sch, sheet 6, Debug]

Parts:
C19: CSTCE12M0G15L99-R0; CSTCE
C20: 1uF; C0805
FB1, FB3, FB4: BLM18PG300SN1D; 0603
J1, J2: USB_MICRO-B_FEMALE-SMT; USB-B-MICRO-SMD
LED11: GREEN; CHIP-LED0805
LED12: RED; CHIP-LED0805
Q2: BC817-25SMD; SOT23-BEC
R23, R24: 470R; M0805
R26: 100k; M0805
R27, R28, R29: x; M0805
U3: MCP2200-I/SS; SSOP20_MC
U4: TPD3E001DRLR; SOT50P160X60-5N

Connections:
+3V3: Q2.C, R23.1, R24.1, U3.4 (N_RST); also elsewhere on the board
GND: C19.2 (22), C20.2, FB3.1, FB4.1, J1.GND, J1.SHIELD1 (SHIELD), J1.SHIELD2 (SHIELD), J1.SHIELD3 (SHIELD), R26.2, R28.2, U3.20 (VSS), U4.3 (GND); also elsewhere on the board
unnamed: LED11.A, R23.2
unnamed: C19.3 (33), U3.3 (OSC2)
unnamed: C19.1 (11), U3.2 (OSC1)
unnamed: J1.D-, U3.18 (D-)
unnamed: J1.D+, U3.19 (D+)
unnamed: C20.1, U3.17 (VUSB)
unnamed: LED12.A, R24.2
unnamed: LED11.C, U3.6 (GP6/RXLED)
unnamed: LED12.C, U3.5 (GP7/TXLED)
unnamed: FB4.2, J2.SHIELD1 (SHIELD), J2.SHIELD2 (SHIELD), J2.SHIELD3 (SHIELD)
unnamed: FB3.2, J2.GND
unnamed: FB1.1, J2.VBUS
unnamed: J2.ID, R26.1, U4.4 (IO3)
unnamed: Q2.E, R27.1
unnamed: Q2.B, R28.1, R29.2
unnamed: J1.VBUS, U3.1 (VDD)
unnamed: FB1.2, R29.1, U4.5 (VCC)
SWD_RX: U3.12 (RX)
SWD_TX: U3.10 (TX)
USB_DATA_N: J2.D-, U4.1 (IO1); also elsewhere on the board
USB_DATA_P: J2.D+, R27.2, U4.2 (IO2); also elsewhere on the board

Notes on the sheet:
USB Virtual COM Port
with USB integrated in STM32
with USB-to-UART Chip

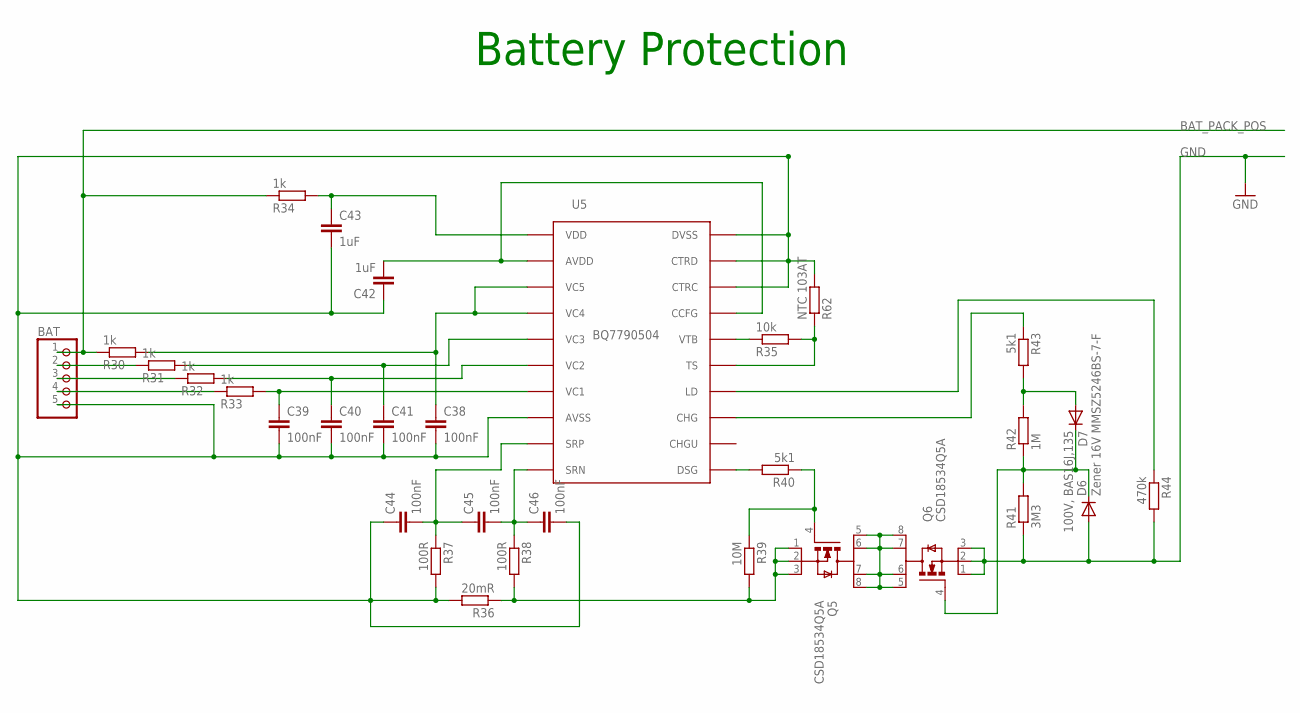
[picture p33: schematic watchplb_mainboard_v1_0.sch, sheet 7, Bat. Prot.]

Parts:
BAT: PINHD-1X5; 1X05
C38, C39, C40, C41, C44, C45, C46: 100nF; C0805K
C42, C43: 1uF; C0805K
D6: Zener 16V MMSZ5246BS-7-F; SOD323-R
D7: 100V, BAS16J,135; SOD323-R
Q5, Q6: CSD18534Q5A; TRANS_CSD18534Q5A
R30, R31, R32, R33, R34: 1k; M0805
R35: 10k; M0805
R36: 20mR; R2512
R37, R38: 100R; M0805
R39: 10M; M0805
R40, R43: 5k1; M0805
R41: 3M3; M0805
R42: 1M; M0805
R44: 470k; M0805
R62: NTC 103AT; M0805
U5: BQ7790504; TSSOP-20/6MM

Connections:
BAT_PACK_GND: BAT.5, C38.2, C39.2, C40.2, C41.2, C42.1, C43.2, C44.1, C46.2, R36.2, R37.2, R62.2, U5.8 (AVSS), U5.18 (CTRC), U5.19 (CTRD), U5.20 (DVSS)
BAT_PACK_POS: BAT.1, R30.1, R34.1; also elsewhere on the board
GND: D6.A, Q6.1, Q6.2, Q6.3, R41.1, R44.2; also elsewhere on the board
unnamed: R35.2, R62.1, U5.15 (TS)
unnamed: D6.C, D7.C, Q6.4, R41.2, R42.1
unnamed: BAT.2, R31.1
unnamed: BAT.3, R32.1
unnamed: BAT.4, R33.1
unnamed: C39.1, R33.2, U5.7 (VC1)
unnamed: C40.1, R32.2, U5.6 (VC2)
unnamed: C41.1, R31.2, U5.5 (VC3)
unnamed: C38.1, R30.2, U5.3 (VC5), U5.4 (VC4)
unnamed: C43.1, R34.2, U5.1 (VDD)
unnamed: Q5.1, Q5.2, Q5.3, R36.1, R38.2, R39.2
unnamed: C42.2, U5.2 (AVDD), U5.17 (CCFG)
unnamed: C45.2, C46.1, R38.1, U5.10 (SRN)
unnamed: C44.2, C45.1, R37.1, U5.9 (SRP)
unnamed: Q5.5, Q5.6, Q5.7, Q5.8, Q6.5, Q6.6, Q6.7, Q6.8
unnamed: R35.1, U5.16 (VTB)
unnamed: Q5.4, R39.1, R40.1
unnamed: R40.2, U5.11 (DSG)
unnamed: D7.A, R42.2, R43.2
unnamed: R43.1, U5.13 (CHG)
unnamed: R44.1, U5.14 (LD)

Notes on the sheet:
BQ7790504
Battery Protection

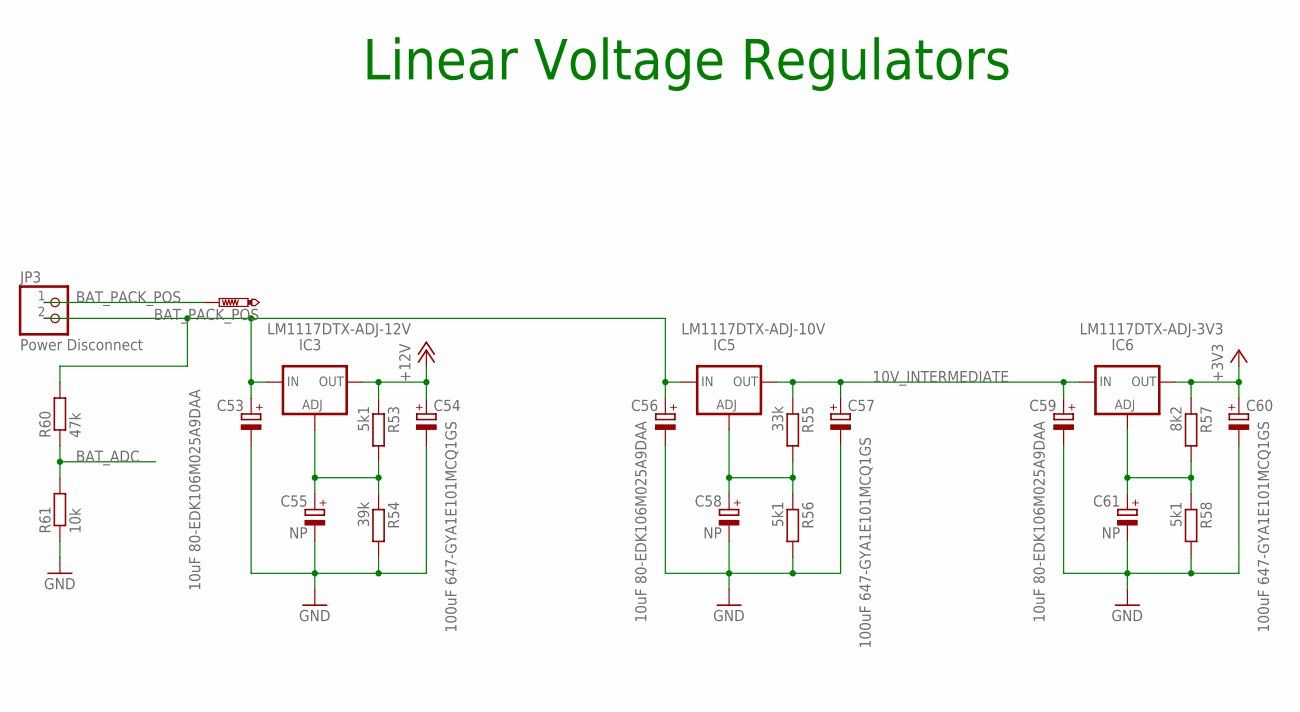
[picture p34: schematic watchplb_mainboard_v1_0.sch, sheet 8, VREG]

Parts:
BAT_PACK_POS: PTR1B1,27; B1,27
C53, C56, C59: 10uF 80-EDK106M025A9DAA; PANASONIC_E
C54, C57, C60: 100uF 647-GYA1E101MCQ1GS; PANASONIC_E
C55, C58, C61: NP; PANASONIC_E
IC3: LM1117DTX-ADJ-12V; TO252
IC5: LM1117DTX-ADJ-10V; TO252
IC6: LM1117DTX-ADJ-3V3; TO252
JP3: Power Disconnect; 1X02
R53, R56, R58: 5k1; M0805
R54: 39k; M0805
R55: 33k; M0805
R57: 8k2; M0805
R60: 47k; M0805
R61: 10k; M0805

Connections:
10V_INTERMEDIATE: C57.+, C59.+, IC5.TAB (OUT), IC6.2 (IN), R55.1
+3V3: C60.+, IC6.TAB (OUT), R57.1; also elsewhere on the board
+12V: C54.+, IC3.TAB (OUT), R53.1; also elsewhere on the board
BAT_ADC: R60.1, R61.2; also elsewhere on the board
BAT_PACK_POS: BAT_PACK_POS.TP, JP3.1; also elsewhere on the board
GND: C53.-, C54.-, C55.-, C56.-, C57.-, C58.-, C59.-, C60.-, C61.-, R54.2, R56.2, R58.2, R61.1; also elsewhere on the board
unnamed: C53.+, C56.+, IC3.2 (IN), IC5.2 (IN), JP3.2, R60.2
unnamed: C55.+, IC3.1 (ADJ), R53.2, R54.1
unnamed: C58.+, IC5.1 (ADJ), R55.2, R56.1
unnamed: C61.+, IC6.1 (ADJ), R57.2, R58.1

Notes on the sheet:
Linear Voltage Regulators

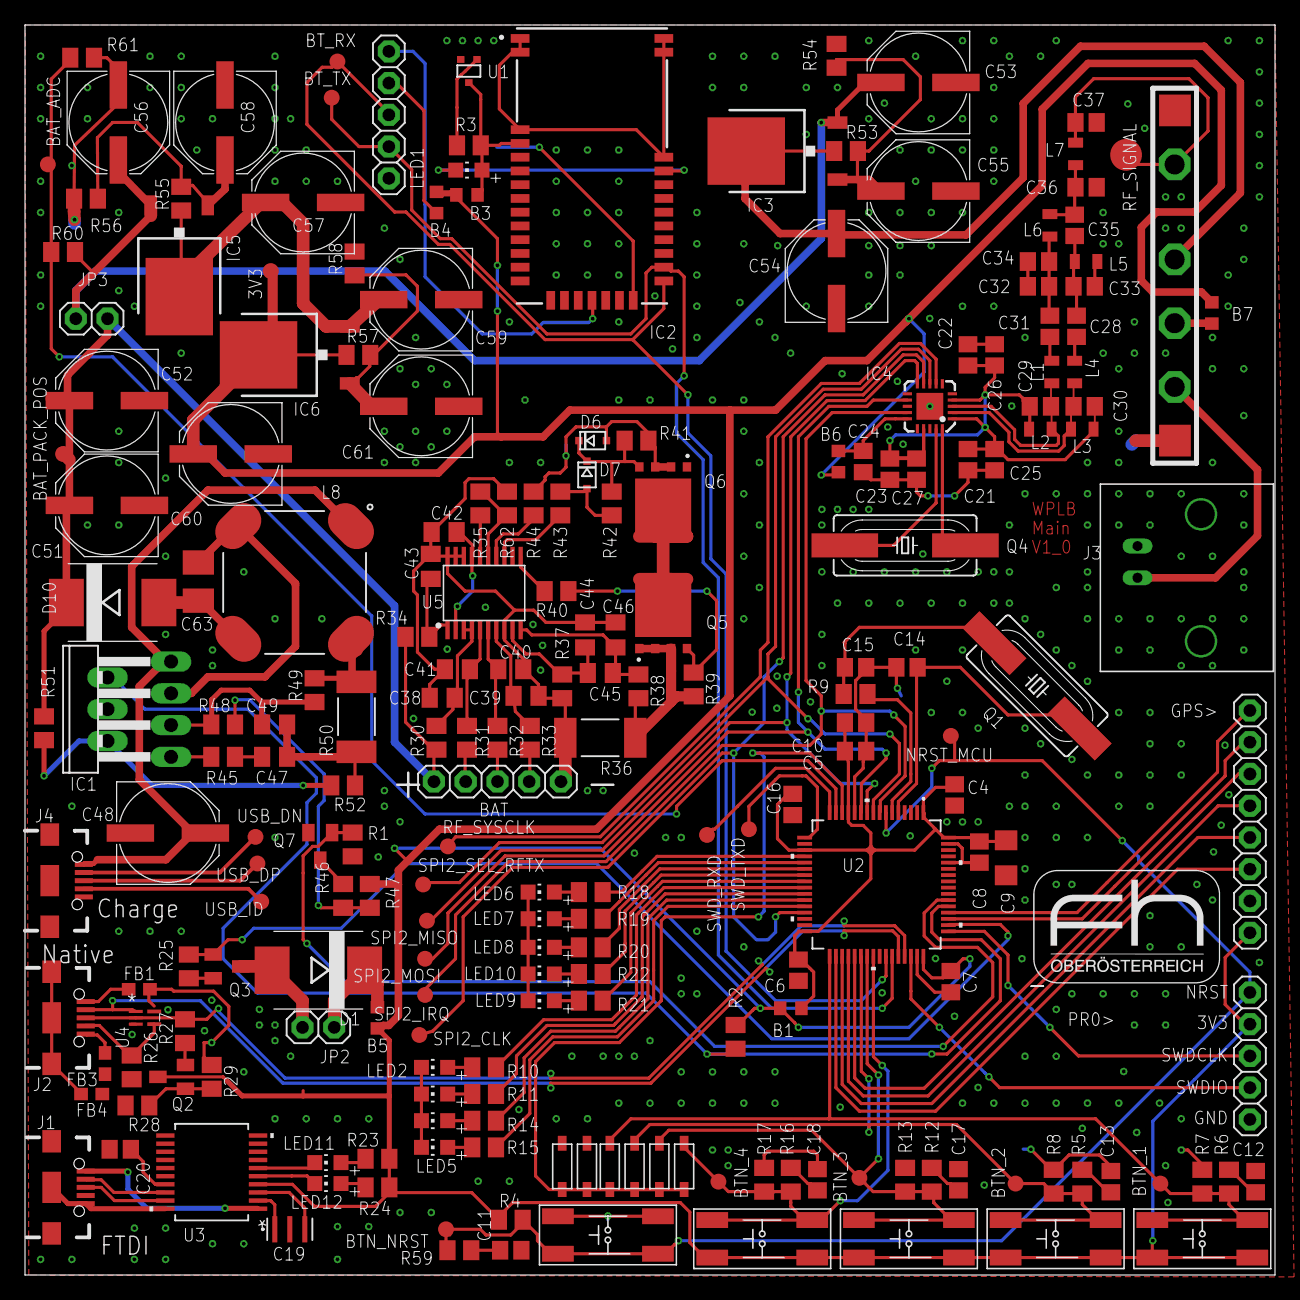
[picture p35: board watchplb_mainboard_v1_0.brd from above]

Board: 2 copper layers, 100.0 x 100.0 mm, 218 parts (1 on the bottom side), 139 nets.

Other parts of the board:
U$4: FH_LOGO
U$5: FH_LOGO_050
