crispycookies/watchPLB/eagle/GPS_board/watchplb_gps_v1.0_AB.brd

## EAGLE design eagle/GPS_board/watchplb_gps_v1.0_AB.brd (2018-12-18)

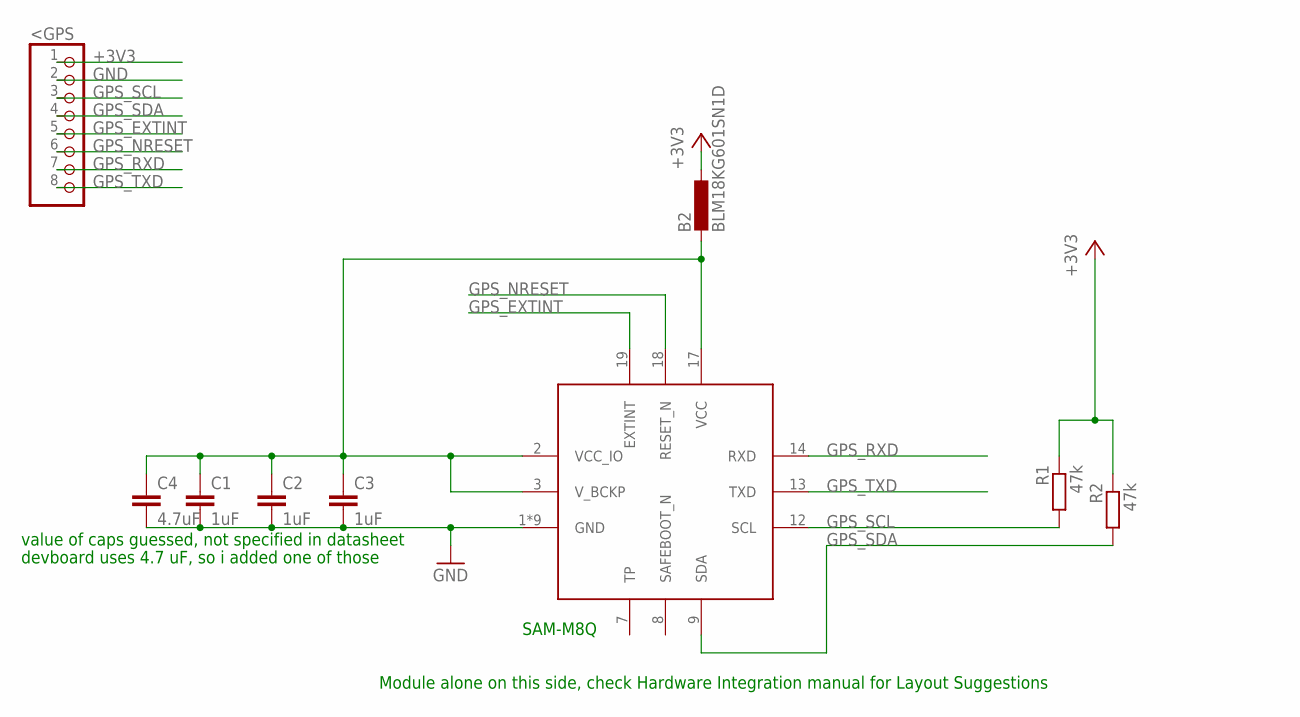
[picture p36: schematic watchplb_gps_v1.0_AB.sch]

Parts:
<GPS: PINHD-1X8; 1X08
B2: BLM18KG601SN1D; L0603
C1, C2, C3: 1uF; C0805
C4: 4.7uF; C0805
IC1: SAM-M8Q
R1, R2: 47k; M0805

Connections:
+3V3: <GPS.1, B2.1, R1.1, R2.1
GND: <GPS.2, C1.2, C2.2, C3.2, C4.2, IC1.1 (GND), IC1.4 (GND), IC1.5 (GND), IC1.6 (GND), IC1.10 (GND), IC1.11 (GND), IC1.15 (GND), IC1.16 (GND), IC1.20 (GND)
GPS_EXTINT: <GPS.5, IC1.19 (EXTINT)
GPS_NRESET: <GPS.6, IC1.18 (RESET_N)
GPS_RXD: <GPS.7, IC1.14 (RXD)
GPS_SCL: <GPS.3, IC1.12 (SCL), R1.2
GPS_SDA: <GPS.4, IC1.9 (SDA), R2.2
GPS_TXD: <GPS.8, IC1.13 (TXD)
unnamed: B2.2, C1.1, C2.1, C3.1, C4.1, IC1.2 (VCC_IO), IC1.3 (V_BCKP), IC1.17 (VCC)

Notes on the sheet:
Module alone on this side, check Hardware Integration manual for Layout Suggestions
value of caps guessed, not specified in datasheet
devboard uses 4.7 uF, so i added one of those
SAM-M8Q

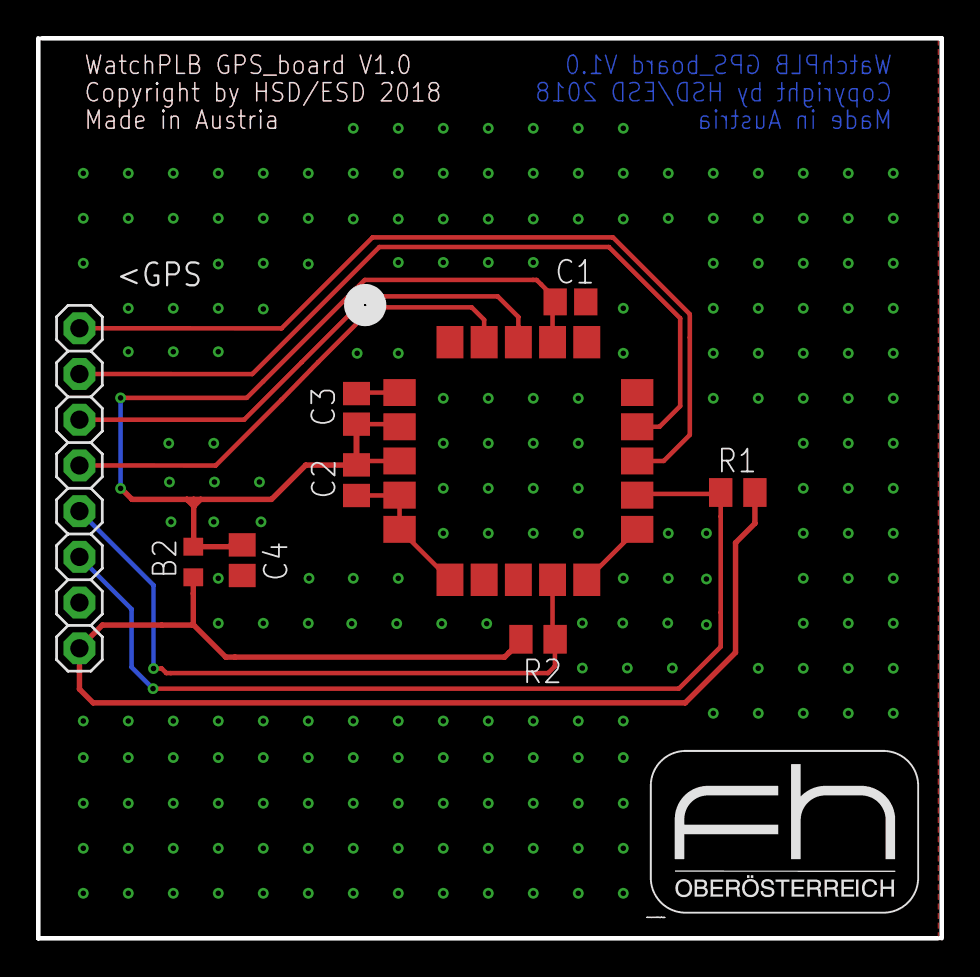
[picture p37: board watchplb_gps_v1.0_AB.brd from above]

Board: 2 copper layers, 50.2 x 50.0 mm, 10 parts (0 on the bottom side), 9 nets.

Other parts of the board:
U$1: FH_LOGO_050
