crispycookies/watchPLB/(commit log)

2018-04-03 initial upload schematic
    [watchplb.sch]
2018-04-03 initial commit schematic
    [watchplb.sch]
2018-04-03 initial upload board
    [watchplb.brd]
2018-04-17 added testpoints, moved pins so pb11 is free to make it pin kompatibel to another prozessor with more power
    [watchplb.brd, watchplb.sch]
2018-04-24 added wakeup pin support and page for psu (empty atm)
    [watchplb.brd, watchplb.sch]
2018-04-24 added auto-generated BOM
    [watchplb_BOM.csv]
2018-04-24 added mouser numbers for most products, changed switches to smd
    [watchplb.brd, watchplb.sch, watchplb_BOM.csv]
2018-04-24 changed mosfet to one with sot23 footprint
    [watchplb.brd, watchplb.sch, watchplb_BOM.csv]
2018-04-24 added new mosfet to bom
    [watchplb_BOM.csv]
2018-05-08 added VCOM usb port with protection
    [watchplb.brd, watchplb.sch]
2018-05-15 added RF transmitter (amp still missing) and generated new pdf of schematic for tobi
    [watchplb.brd, watchplb.sch]
2018-05-15 added rf amp and sma connector, reorganised for better pdf page ordering
    [watchplb.brd, watchplb.sch]
2018-05-16 added battery protection circuit
    [watchplb.brd, watchplb.sch]
2018-05-22 added calculations as excel file and battery charge circuitry in schematic
    [Berechnungen.xlsx, watchplb.brd, watchplb.sch]
2018-05-26 added linear regulators + calculations for them, exported parts as library, generated new pdf
    [Berechnungen.xlsx, watchplb.brd, watchplb.sch]
2018-05-26 added 4.7uF to gps module because the devboard does that.
    [watchplb.brd, watchplb.sch]
2018-05-29 added missing names + new pdf
    [watchplb.sch]
2018-05-29 small schematic changes, started with layout
    [Berechnungen.xlsx, watchplb.brd, watchplb.sch]
2018-06-05 added some datasheets and continued with layout
    [watchplb.brd, watchplb.sch]
2018-06-05 continued layout
    [watchplb.brd, watchplb.sch]
2018-06-12 layout v1 fertig
    [watchplb.brd, watchplb.sch]
2018-06-12 added text and fh logo
    [watchplb.brd, watchplb.sch]
2018-06-19 changes requested by armin brandl
    [watchplb_gps_v1_1.brd, watchplb_gps_v1_1.sch, watchplb_mainboard_v1_1.brd, watchplb_mainboard_v1_1.sch]
2018-06-22 weitere Änderungen von Armin Brandl
    [watchplb_mainboard_v1_1.brd]
2018-07-11 von Armin überarbeitete Version der GPS-Platine
    [watchplb_gps_v1.0_AB.brd, watchplb_gps_v1.0_AB.sch]
2018-07-11 Änderungen laut Besprechung mit Armin (soweit ich mich erinnern kann, ist schon ne woche her)
    [watchplb_mainboard_v1_0.brd, watchplb_mainboard_v1_0.sch]
2018-07-18 kleine Änderungen laut email mit Armin, veraltete Dateien entfernt, gerber generiert
    [watchplb_mainboard_v1_0.brd]
2018-07-18 modified gitignore so gerber files get committed too
2018-07-20 started BOM
    [BOMs.xlsx, watchplb_mainboard_v1_0.brd, watchplb_mainboard_v1_0.sch]
2018-07-26 BOMs finished, requesting feedback from Armin Brandl
    [BOMs.xlsx, BOMs_WatchPLB.xlsx, watchplb_BOM.csv]
2018-07-27 changes to BOM as requested by Armin Brandl
    [BOMs_WatchPLB.xlsx]
2018-07-27 small changes
    [BOMs_WatchPLB.xlsx]
2018-09-29 Marked received Parts on BOM
    [BOMs_WatchPLB.xlsx]
2018-09-29 Noticed that I forgot to apply the Calculations for Linear Voltage Regulators to eagle, fixed this
    [Berechnungen.xlsx, watchplb_mainboard_v1_0.brd, watchplb_mainboard_v1_0.sch]
2018-10-15 small schematic changes
    [BOMs_WatchPLB.xlsx, Berechnungen.xlsx, watchplb_mainboard_v1_0.brd, watchplb_mainboard_v1_0.sch]
2018-12-11 Accumulated Changes over a few weeks
    [Berechnungen.xlsx, watchplb_gps_v1.0_AB.brd, watchplb_mainboard_v1_0.brd, watchplb_mainboard_v1_0.sch]
2018-12-18 einige kleine Änderungen: mcp111 ist smd massen verbinden taster footprint richtig orientierungspunkt U5 BQ ding richtungsmarkierung bei diode im Bat prot reset leitung bei pin verbinden LED rs auf 4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
    [watchplb_gps_v1.0_AB.brd, watchplb_mainboard_v1_0.brd, watchplb_mainboard_v1_0.sch]
2019-01-08 + started doku
    [watchplb_mainboard_v1_0.brd]
