crispycookies/watchPLB/(notices)

Notices in the files:
eagle/GPS_board/watchplb_gps_v1.0_AB.brd:
Copyright by HSD/ESD 2018
parts and their libraries:
SparkFun-Connectors: Licensing: Creative Commons ShareAlike 4.0 International - https://creativecommons.org/licenses/by-sa/4.0
